volzotan/CompressorCam/README.md

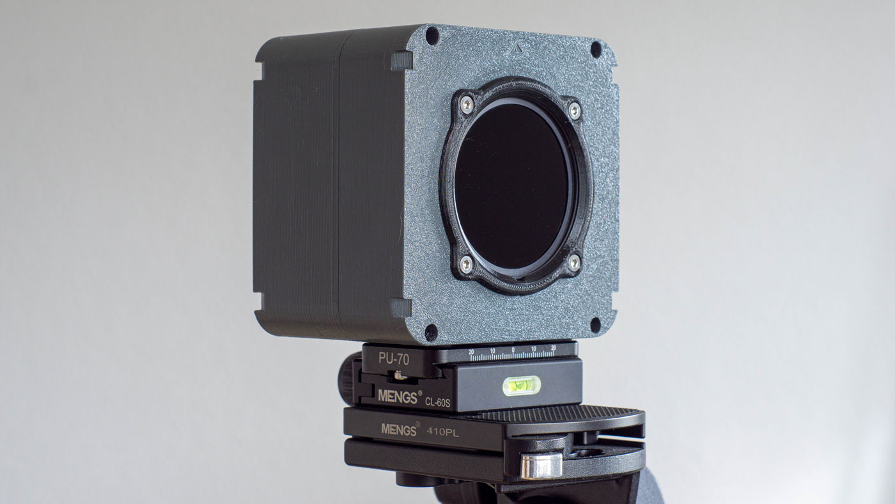
[picture p1: docs/images/front_hero.jpg]
CompressorCam


This is the complete hard- and software for the CompressorCam, a camera to capture digital solargraphy images.
For more information, refer to the [Digital Solargraphy](http://digitalsolargraphy.com) website or the README files in the subdirectories.
