volzotan/CompressorCam/hardware/README.md

# Hardware:

## Parameters for 3D-printing

Print in PETG or similarly heat-resistant material.  
The top and bottom shell of the enclosure need to be printed on a 0.4mm nozzle printer with a layer height of 0.2-0.23mm. The PogoHolder (the spacer in between PCB and Raspberry Pi Zero) needs to be printed with a 0.25mm nozzle.  
4 perimeters and an infill of 15% are reasonable.   

Avoid the color black, PETG temperatures after a few hours in the sun:
  * black: 50°C
  * dark gray: 45°C
  * white: 32°C

## BOM:

| Quantity | Type | Name | Function | 
| --- | --- | --- | --- |
| 4 | DIN912  | M3 50mm | Screw Top-Bottom | 
| 4 | DIN912  | M3 6mm  | Screw Top-Insert | 
| 4 | DIN7991 | M3 5mm  | Screw FilterHolder-Top  | 
| 8 | DIN912  | M2.5 12mm | | 
| 4 | DIN912  | M2.5 35mm | | 
| 8 | Heat-Insert | M2.5 D4.2 L5 | Insert Lens Holder  | 
| 4 | Heat-Insert | M3 D4.2 L3  | Insert Top  | 
| 8 | Heat-Insert | M3 D4.2 L7  | Insert Bottom | 
| 4 | DIN934  | M2.5 | Nut Camera Module  | 
| 1 | DIN934  | 1/4"-20 | Tripod-Nut  | 
| 162g | PETG | Filament | Top&Bottom  | 
| 25g | PETG | Filament | Everything Else | 
| 1 | | Micro SD-Card | | 
| 1 | ND64 58mm | Neutral-Density filter  | | 
| 40cm | 3mm | EPDM foam band  | | 
| 1 | 2S1P | Battery holder  | | 
| 2 | | 18650 battery | | 
| 1 | | CompressorCam board | | 
| 1 | | Pi Zero camera cable short  | | 
| 1 | | Raspberry Pi Zero W | | 
| 1 | | Raspberry Pi Camera Module HQ | |  
| 1 | | C or CS-Mount lens  | | 

# Change Log: 

## Circuit Boards:

Revision J:

  * no changes

Revision I:

  * new DCDC converter chip (TPS630701) allows 3-13V input (revH only supported 6-13V)
  * board can now be powered via MicroUSB as well 

Revision H:

  * initial release
