volzotan/CompressorCam/software/README.md

**buildroot**: All files to build a buildroot linux image including the required packages for the compressor camera software  
**bootloader**: the Arduino bootloader for the companion board  
**controllerCompressorCam**: the firmware for the companion board  
**ccam**: The python compressor camera scripts  
**compressor**: The software for stacking and peaking the captured photos to create the final solargraphy image
