volzotan/CompressorCam/software/ccam/README.md

`ccam.py` and `devices.py` are the only files required for barebones functionality.
