volzotan/CompressorCam/docs/examples.md

---
title: Example Images
imgdir: examples
permalink: examples/
---

Weimar Marktplatz
Weimar Marktplatz

Exposed for 48 hours  
3.2mm No-Name CS-Mount lens

---

Weimar Theaterplatz

Exposed for 48 hours  
4mm Arecont CS-Mount lens

---

Rudolfshuette2

Exposed for 24 hours  
3.2mm No-Name CS-Mount lens

---

Rudolfshuette3

Exposed for 12 hours  
4mm Arecont CS-Mount lens
