volzotan/CompressorCam/docs/imprint.md

---
title: Imprint
---

Legal information: This website is run by  

Christopher Getschmann  
Prager Str. 1 (C46)  
D-99427 Weimar (Germany)  

If you want to reach out to me: solargraphy@volzo.de
