volzotan/CompressorCam/docs/_assets/examples/marktplatz.jpg

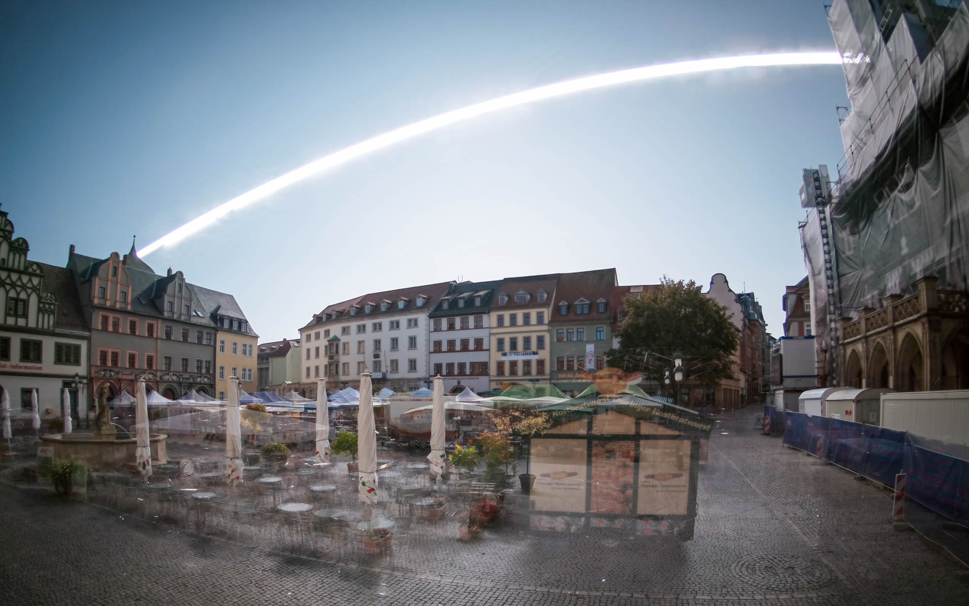
docs/_assets/examples/marktplatz.jpg
