volzotan/CompressorCam/docs/_assets/examples/regular_low_overview.jpg

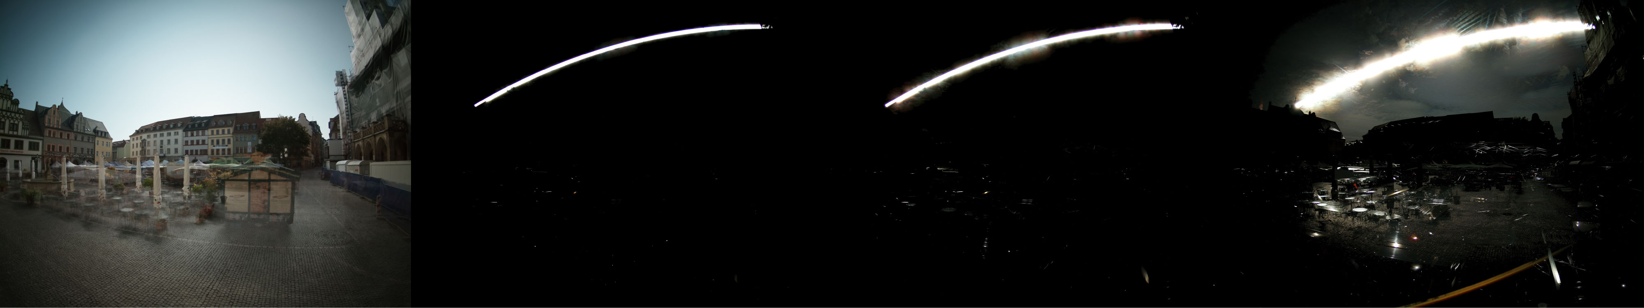
docs/_assets/examples/regular_low_overview.jpg
