volzotan/CompressorCam/docs/_assets/examples/rudolfshuette2.jpg

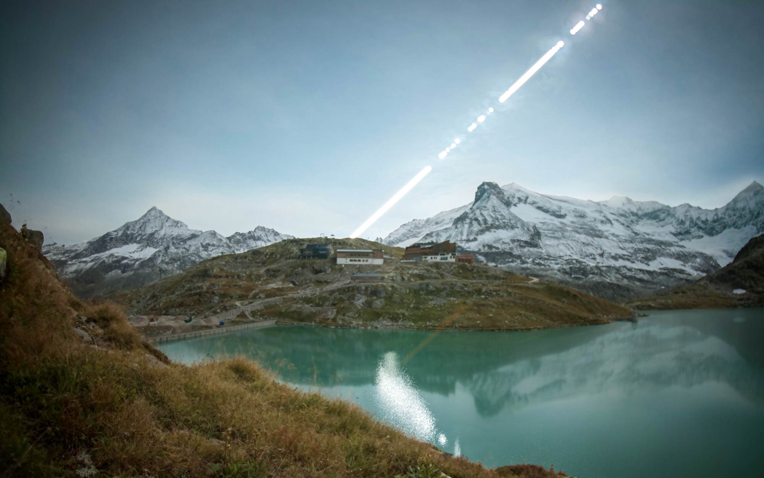
docs/_assets/examples/rudolfshuette2.jpg
