volzotan/CompressorCam/docs/_assets/examples/rudolfshuette3.jpg

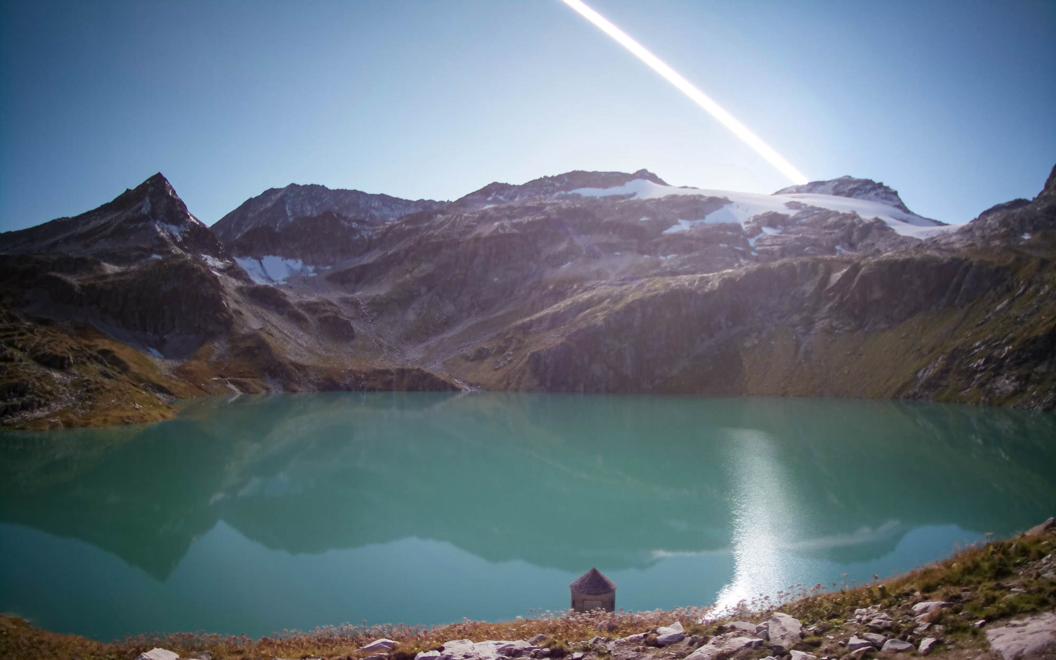
docs/_assets/examples/rudolfshuette3.jpg
