volzotan/CompressorCam/docs/_assets/examples/theaterplatz.jpg

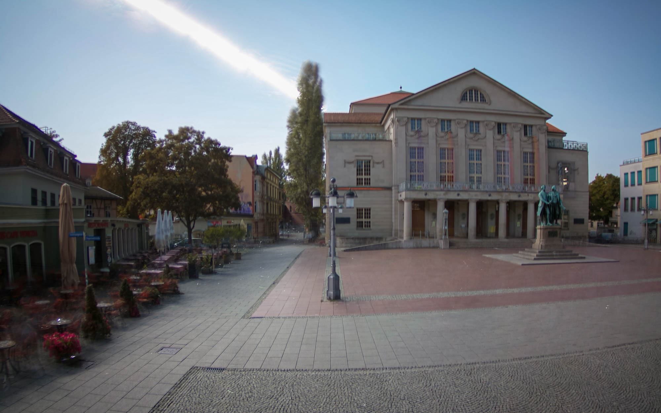
docs/_assets/examples/theaterplatz.jpg
