volzotan/CompressorCam/docs/_assets/howitworks/captures_3_cap_000750_ev_18.77.jpg

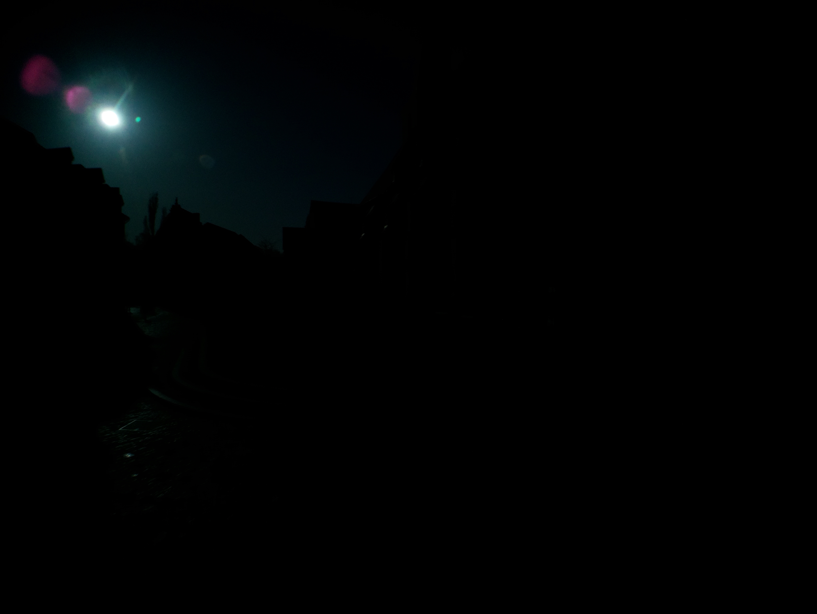
docs/_assets/howitworks/captures_3_cap_000750_ev_18.77.jpg
