volzotan/CompressorCam/docs/_assets/howitworks/herderplatz_only_averaging.jpg

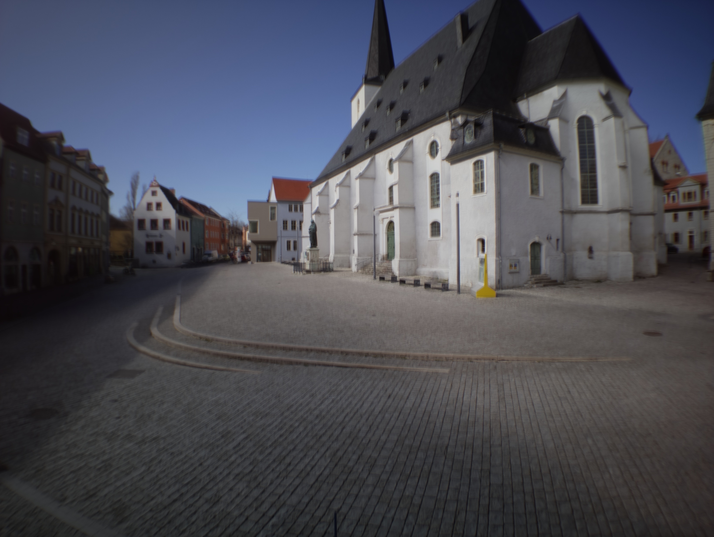
docs/_assets/howitworks/herderplatz_only_averaging.jpg
