volzotan/CompressorCam/docs/_assets/howitworks/sun_arc_artifacts.png

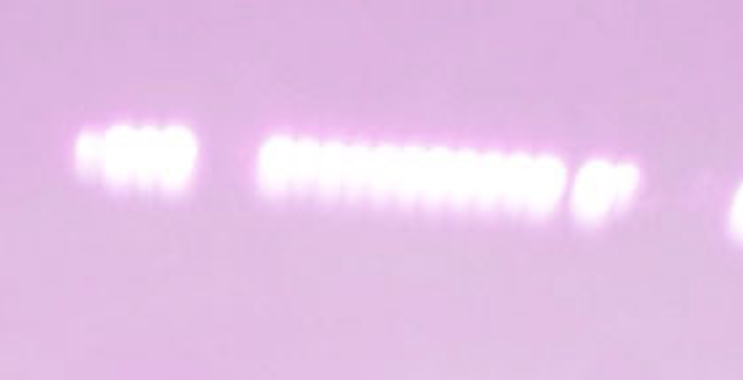
docs/_assets/howitworks/sun_arc_artifacts.png
