volzotan/CompressorCam/docs/_assets/howitworks/weimarhallenpark.jpg

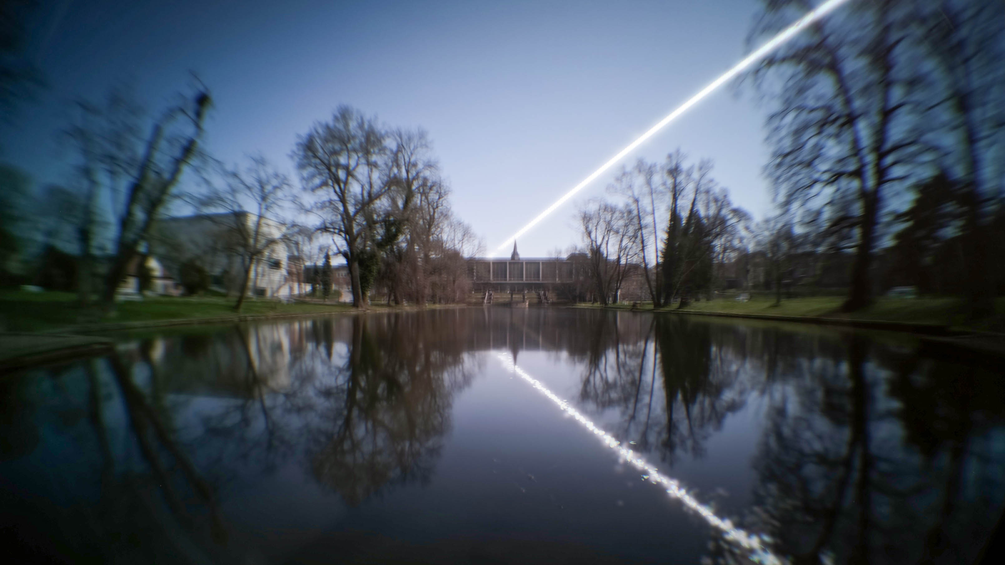
docs/_assets/howitworks/weimarhallenpark.jpg
