volzotan/CompressorCam/docs/assets/howitworks/captures_1_cap_000750_ev_11.24.jpg

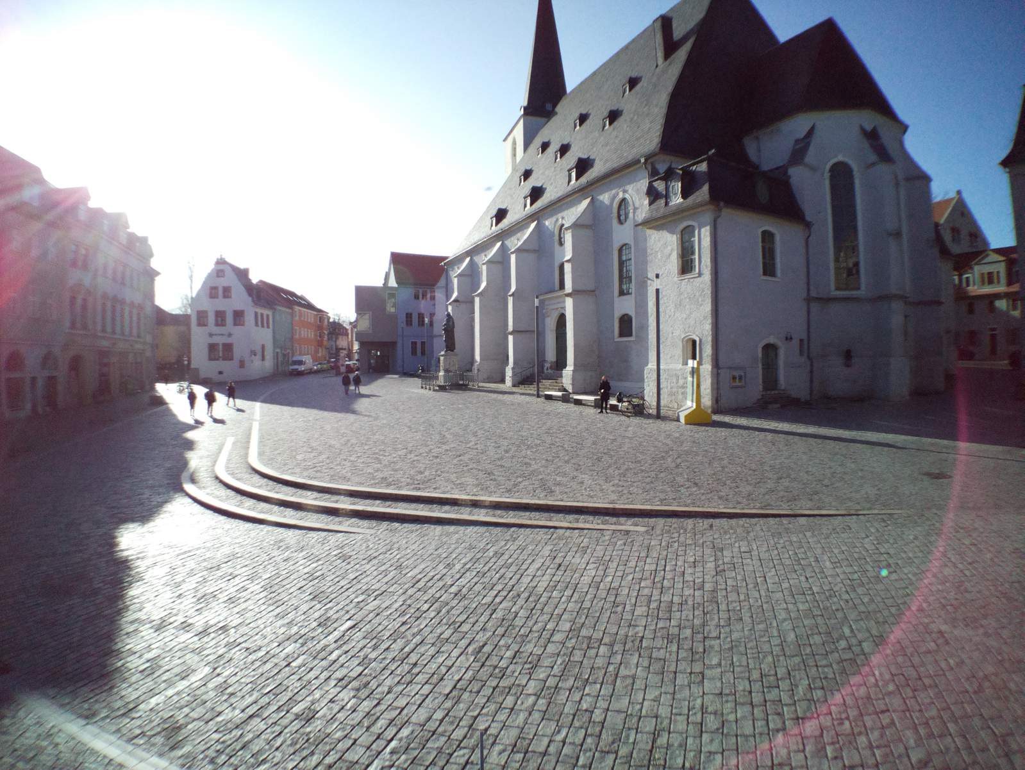
docs/assets/howitworks/captures_1_cap_000750_ev_11.24.jpg
