volzotan/CompressorCam/docs/images/front_exampleimages.jpg

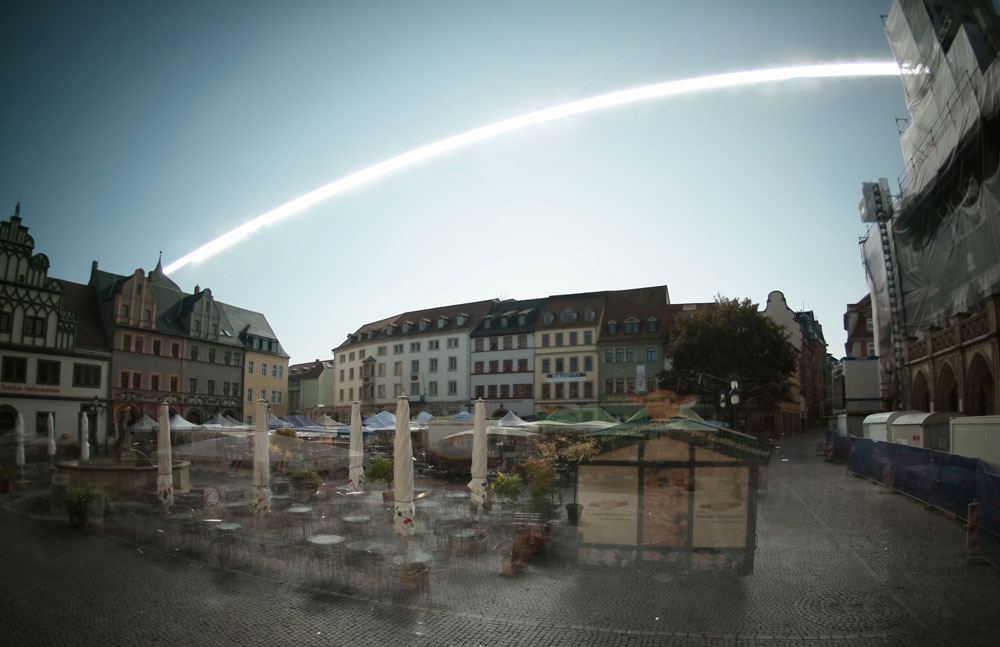
docs/images/front_exampleimages.jpg
