volzotan/CompressorCam/docs/images/front_hero2.jpg

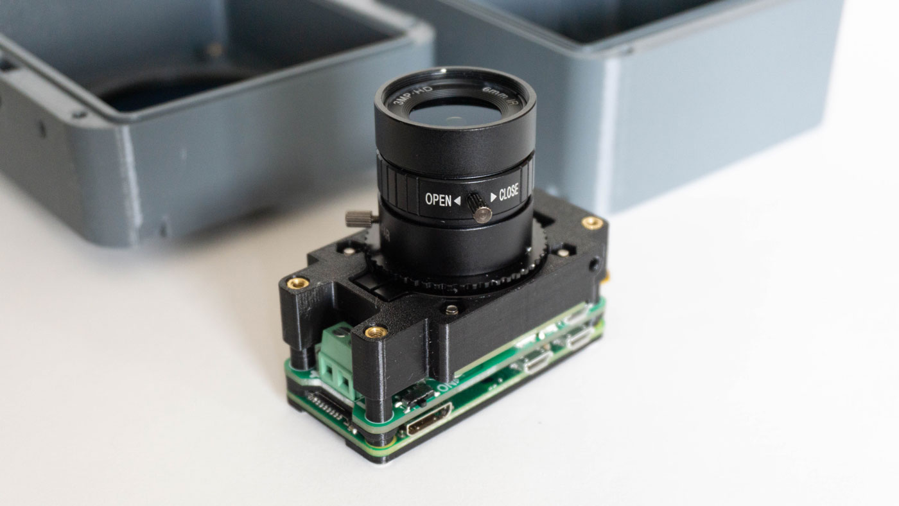
docs/images/front_hero2.jpg
