volzotan/CompressorCam/docs/images/front_hero3.jpg

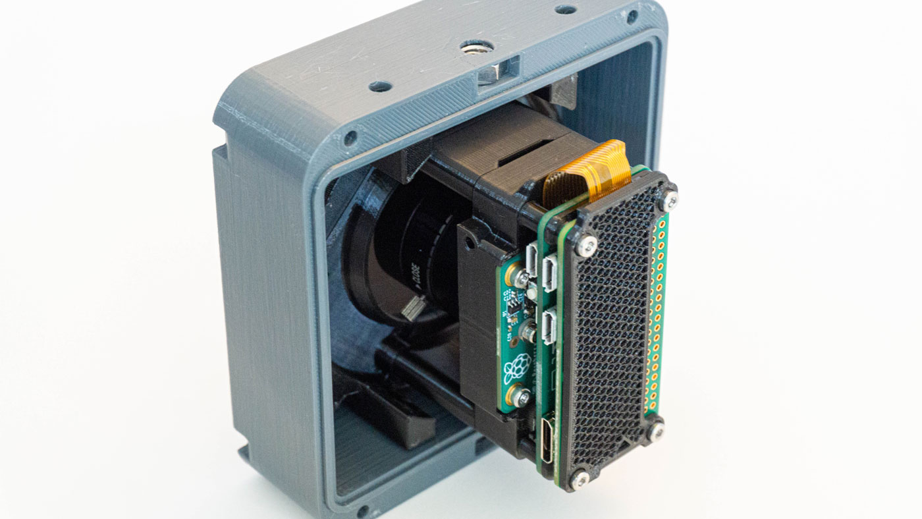
docs/images/front_hero3.jpg
