volzotan/CompressorCam/docs/images/front_screenshot.png

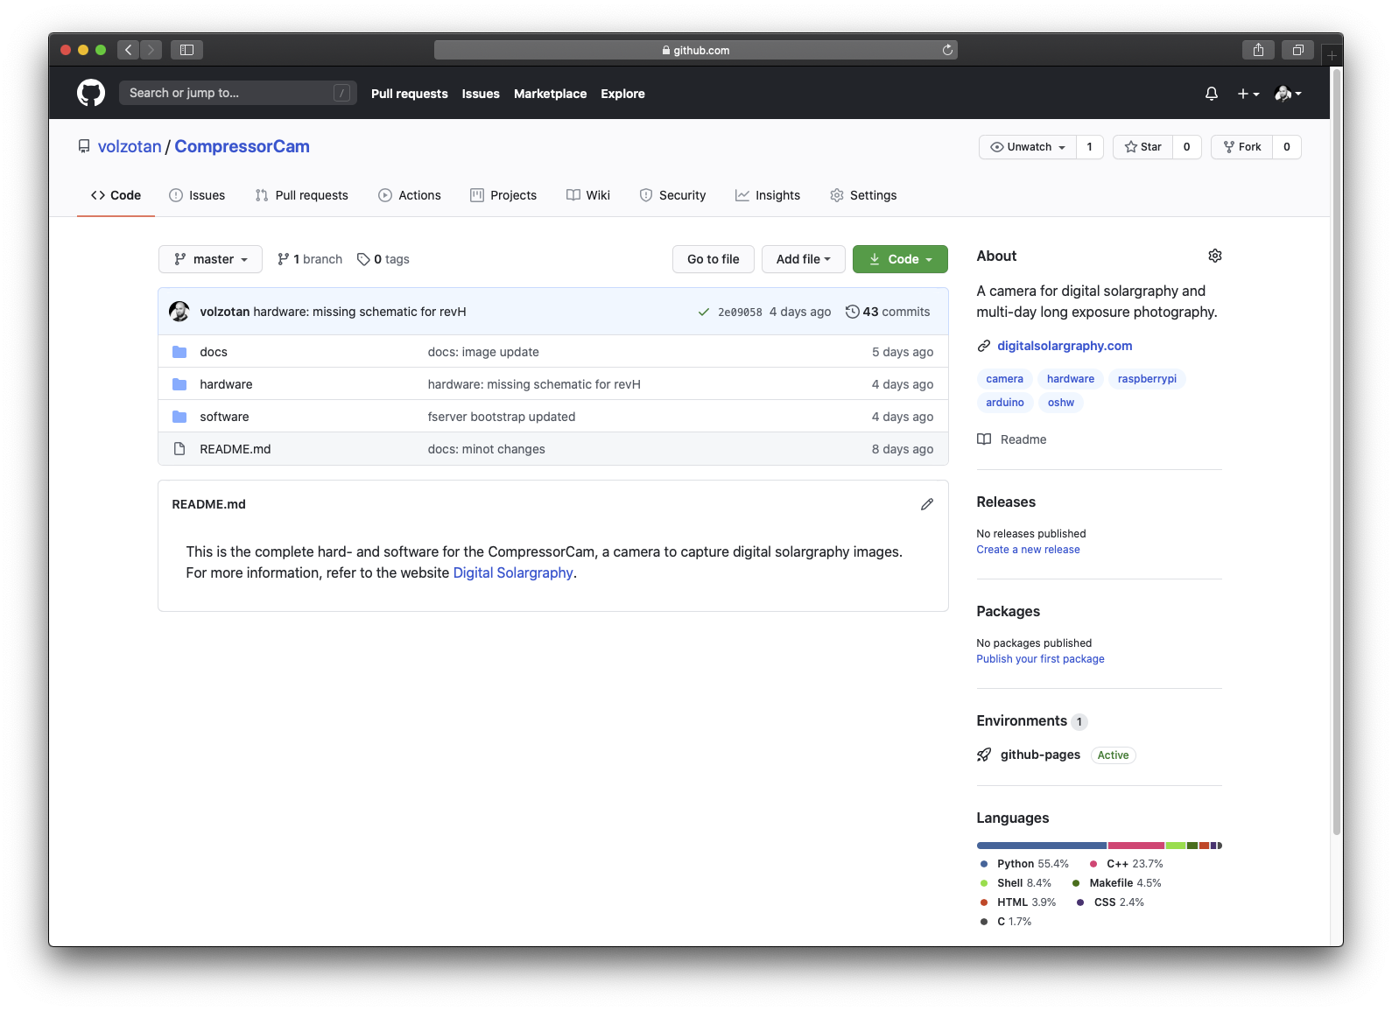
docs/images/front_screenshot.png
