volzotan/CompressorCam/hardware/gerbers/CompressorCamRevJ/BOM_CompressorCamRevJ.csv

ID | Name | Designator | Footprint | Quantity | Manufacturer Part | Manufacturer | Supplier | Supplier Part | LCSC Assembly
1 | 210S-2*5P L=11.6MMGold-plated black | H2 | HDR-TH_10P-P2.54-V-R2-C5-S2.54_MTP125-1205S1 | 1 | 210S-2*5P L=11.6MMGold-plated black | Ckmtw | LCSC | C124387
2 | SSSS811101 | SW1 | SW-TH_SSSS811101 | 1 | SSSS811101 | ALPS | LCSC | C109335
3 | 100nF | C1,C5,C13,C10 | C0805 | 4 | CC0805KRX7R9BB104 | YAGEO | LCSC | C49678 | Yes
4 | 100K | R11,R12,R14,R2 | R0805 | 4 | 0805W8F1003T5E | UniOhm | LCSC | C17407 | Yes
5 | 22uF | C7,C8,C9 | C0805 | 3 | CL21A226MAQNNNE | SAMSUNG | LCSC | C45783 | Yes
6 | 32.768KHz | X1 | OSC-SMD_L3.2-W1.5 | 1 | 9H0321LCSC-DZF2S | TXC | LCSC | C90944 | Yes
7 | MCP1703T-3302E/MB | U5 | SOT-89-3_L4.5-W2.5-P1.50-LS4.2-BR | 1 | MCP1703T-3302E/MB | MICROCHIP | LCSC | C27287 | Yes
8 | WS2812B-B | LED2 | LED-SMD_4P-L5.0-W5.0-TL_WS2812B-B | 1 | WS2812B-B | Worldsemi | LCSC | C114586 | Yes
9 | SKRTLAE010 | SW2 | KEY-SMD_SKRTLAE010 | 1 | SKRTLAE010 | ALPS | LCSC | C110293
10 | 10uF | C17,C6,C18,C19,C20 | C0805 | 5 | CL21A106KAYNNNE | SAMSUNG | LCSC | C15850 | Yes
11 | TC2030 | J2 | TAG-CONNECT_TC2030-IDC-NL | 1
12 | 33K | R13 | R0805 | 1 | 0805W8F3302T5E | UniOhm | LCSC | C17633 | Yes
13 | TPS2113APWR | U3 | TSSOP-8_L4.4-W3.0-P0.65-LS6.4-BL | 1 | TPS2113APWR | TI | LCSC | C130052 | Yes
14 | ATSAMD21G18A-AU | U1 | TQFP-48_L7.0-W7.0-P0.50-LS9.0-BL | 1 | ATSAMD21G18A-AU | MICROCHIP | LCSC | C78624 | Yes
15 | AP2553W6-7 | U6 | SOT-26_L3.0-W1.6-P0.95-LS2.8-BL | 1 | AP2553W6-7 | Diodes Incorporated | LCSC | C212302
16 | U-F-M5DD-Y-L | USB1 | MICRO-USB-SMD_MICRO-USB-18 | 1 | U-F-M5DD-Y-L | HRO | LCSC | C91146
17 | 100uF | C15 | C1210 | 1 | CL32A107MQVNNNE | SAMSUNG | LCSC | C49066 | Yes
18 | LM75AD | U8 | SOIC-8_L5.0-W4.0-P1.27-LS6.0-BL | 1 | LM75AD | NXP | LCSC | C7963 | Yes
19 | TPS630701RNMT | U4 | VQFN-15_L3.0-W2.5-P0.50-BL | 1 | TPS630701RNMT | TI | LCSC | C181473
20 | JUMPER-2SMD-NO | JP1 | SJ_2S-NO | 1
21 | 1.5uH | L1 | IND-SMD_L5.4-W5.2 | 1 | MWSA0518S-1R5MT | Sunlord | LCSC | C408344 | Yes
22 | 27pF | C3,C4 | C0805 | 2 | CL21C270JBANNNC | SAMSUNG | LCSC | C8031 | Yes
23 | Header-Female-2.54_1x3 | P1 | HDR-TH_3P-P2.54-V | 1 | Header-Female-2.54_1x3 | Boom Precision Elec | LCSC | C146243
24 | 510 | R17 | R0805 | 1 | 0805W8F5100T5E | UniOhm | LCSC | C17734 | Yes
25 | 10K | R1,R6,R7,R8,R9,R10,R15,R3 | R0805 | 8 | 0805W8F1002T5E | UniOhm | LCSC | C17414 | Yes
26 | JL127-50802G01 | U7 | CONN-TH_2P-P5.08_JL127-50802G01 | 1 | JL127-50802G01 | JILN | LCSC | C409161
27 | 1uF | C2,C14,C16,C11,C12 | C0805 | 5 | CL21B105KBFNNNE | SAMSUNG | LCSC | C28323 | Yes
