volzotan/CompressorCam/hardware/gerbers/CompressorCamRevH/BOM_CompressorCamRevH.csv

ID | Name | Designator | Footprint | Quantity | Manufacturer Part | Manufacturer | Supplier | Supplier Part | LCSC Assembly
1 | 10uH | L1 | IND-SMD_L7.1-W6.6 | 1 | MWSA0618-100MT | Sunlord | LCSC | C132135 | Yes
2 | 210S-2*5P L=11.6MMGold-plated black | H2 | HDR-TH_10P-P2.54-V-R2-C5-S2.54_MTP125-1205S1 | 1 | 210S-2*5P L=11.6MMGold-plated black | Ckmtw | LCSC | C124387
3 | SSSS811101 | SW1 | SW-TH_SSSS811101 | 1 | SSSS811101 | ALPS | LCSC | C109335
4 | 100nF | C6,C13,C1,C5 | C0805 | 4 | CC0805KRX7R9BB104 | YAGEO | LCSC | C49678 | Yes
5 | 100K | R2,R11 | R0805 | 2 | 0805W8F1003T5E | UniOhm | LCSC | C17407 | Yes
6 | 22uF | C10 | C1206 | 1 | CL31A226KPHNNNE | SAMSUNG | LCSC | C5672 | Yes
7 | MCP9808-E/MS | U3 | MSOP-8_L3.0-W3.0-P0.65-LS4.9-TL | 1 | MCP9808-E/MS | Microchip Tech | LCSC | C94847 | Yes
8 | 32.768KHz | X1 | OSC-SMD_L3.2-W1.5 | 1 | 9H0321LCSC-DZF2S | TXC | LCSC | C90944 | Yes
9 | B340A | D1 | SMA_L4.3-W2.6-LS5.2-RD | 1 | B340A | MDD | LCSC | C64982 | Yes
10 | MCP1703T-3302E/MB | U5 | SOT-89-3_L4.5-W2.5-P1.50-LS4.2-BR | 1 | MCP1703T-3302E/MB | MICROCHIP | LCSC | C27287 | Yes
11 | WS2812B-B | LED2 | LED-SMD_4P-L5.0-W5.0-TL_WS2812B-B | 1 | WS2812B-B | Worldsemi | LCSC | C114586 | Yes
12 | SKRTLAE010 | SW2 | KEY-SMD_SKRTLAE010 | 1 | SKRTLAE010 | ALPS | LCSC | C110293
13 | 10uF | C17 | C0805 | 1 | CL21A106KAYNNNE | SAMSUNG | LCSC | C15850 | Yes
14 | MP2307DN-LF-Z | U2 | SOP-8_L4.9-W3.9-P1.27-LS6.0-BL-EP | 1 | MP2307DN-LF-Z | MPS | LCSC | C18921 | Yes
15 | 6.8K | R3 | R0805 | 1 | 0805W8F6801T5E | UniOhm | LCSC | C17772 | Yes
16 | TC2030 | J2 | TAG-CONNECT_TC2030-IDC-NL | 1
17 | 33K | R13 | R0805 | 1 | 0805W8F3302T5E | UniOhm | LCSC | C17633 | Yes
18 | ATSAMD21G18A-AU | U1 | TQFP-48_L7.0-W7.0-P0.50-LS9.0-BL | 1 | ATSAMD21G18A-AU | MICROCHIP | LCSC | C78624 | Yes
19 | AP2553W6-7 | U6 | SOT-26_L3.0-W1.6-P0.95-LS2.8-BL | 1 | AP2553W6-7 | Diodes Incorporated | LCSC | C212302
20 | U-F-M5DD-Y-L | USB1 | MICRO-USB-SMD_MICRO-USB-18 | 1 | U-F-M5DD-Y-L | HRO | LCSC | C91146
21 | 3.9uF | C19 | C0805 | 1 | CL21B335KPFNNNE | Samsung Electro-Mechanics | LCSC | C159775 | Yes
22 | 100uF | C15 | C1210 | 1 | CL32A107MQVNNNE | SAMSUNG | LCSC | C49066 | Yes
23 | 10uF | C7 | C1206 | 1 | CL31A106KBHNNNE | SAMSUNG | LCSC | C13585 | Yes
24 | JUMPER-2SMD-NO | JP1 | SJ_2S-NO | 1
25 | 27pF | C3,C4 | C0805 | 2 | CL21C270JBANNNC | SAMSUNG | LCSC | C8031 | Yes
26 | Header-Female-2.54_1x3 | P1 | HDR-TH_3P-P2.54-V | 1 | Header-Female-2.54_1x3 | Boom Precision Elec | LCSC | C146243
27 | 10K | R4,R1,R6,R7,R8,R9,R10 | R0805 | 7 | 0805W8F1002T5E | UniOhm | LCSC | C17414 | Yes
28 | JL127-50802G01 | U7 | CONN-TH_2P-P5.08_JL127-50802G01 | 1 | JL127-50802G01 | JILN | LCSC | C409161
29 | 44.2K | R5 | R0805 | 1 | 0805W8F4422T5E | UniOhm | LCSC | C17697 | Yes
30 | 1uF | C11,C12,C2,C14,C16 | C0805 | 5 | CL21B105KBFNNNE | SAMSUNG | LCSC | C28323 | Yes
31 | 10nF | C9 | C0805 | 1 | CL21B103KBANNNC | SAMSUNG | LCSC | C1710 | Yes
