volzotan/CompressorCam/hardware/STEPs/LensHolderLQ.step

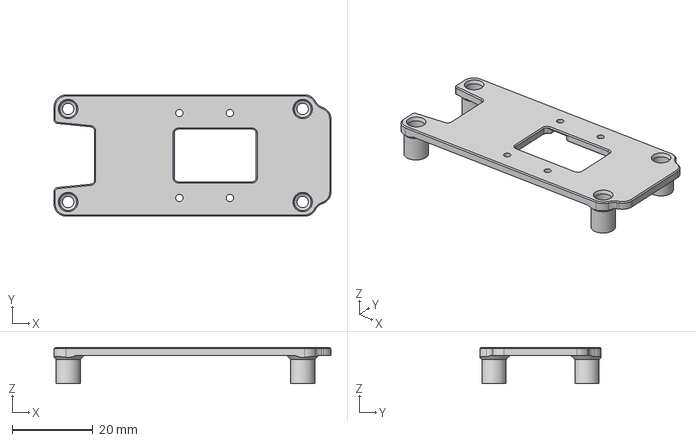
[picture p16: CAD file, 2025-11-16]
hardware/STEPs/LensHolderLQ.step
68.5 x 30.0 x 9.00 mm
