volzotan/CompressorCam/hardware/STLs/CCE_M_MagnetHolder.stl

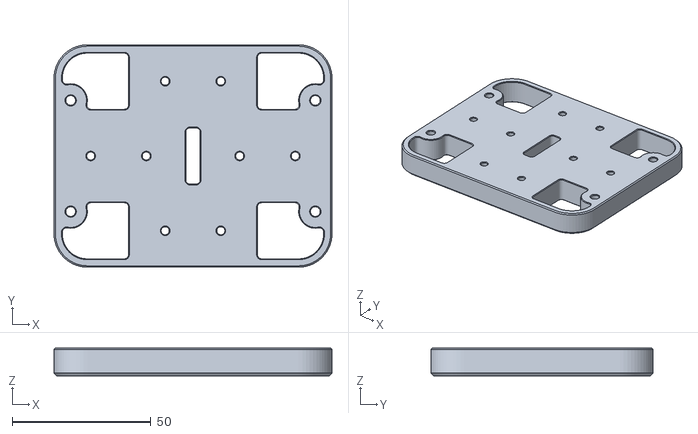
[picture p17: CAD file, 2025-11-16]
hardware/STLs/CCE_M_MagnetHolder.stl
100.0 x 80.0 x 10.0
