volzotan/CompressorCam/hardware/STEPs/LensHolderHQ.step

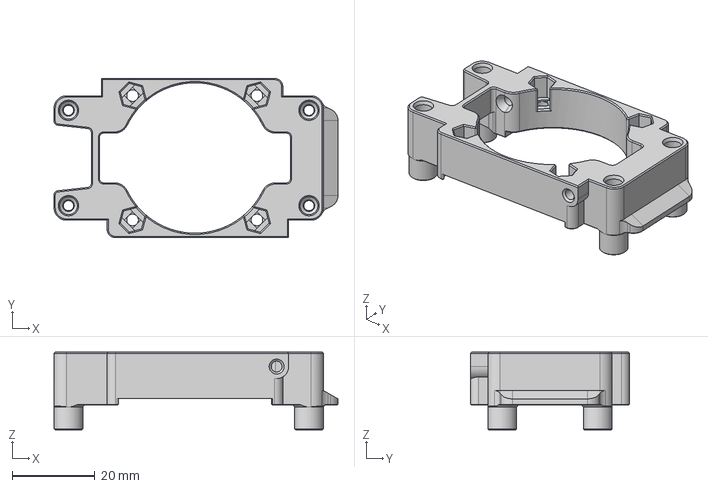
[picture p18: CAD file, 2025-11-16]
hardware/STEPs/LensHolderHQ.step
68.5 x 38.4 x 18.8 mm
