volzotan/CompressorCam/hardware/STLs/LensHolderHQ_BottomWago.stl

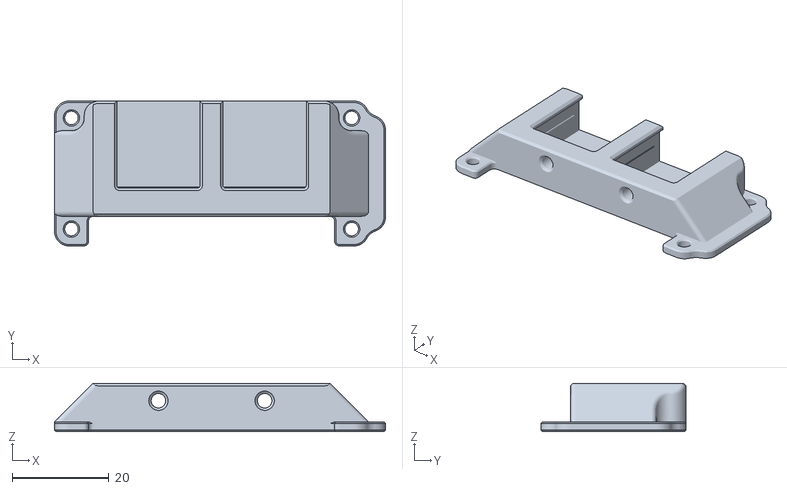
[picture p19: CAD file, 2025-11-16]
hardware/STLs/LensHolderHQ_BottomWago.stl
68.5 x 30.0 x 10.0
