volzotan/CompressorCam/hardware/STEPs/DigitalSolargraphyCamera v28.step

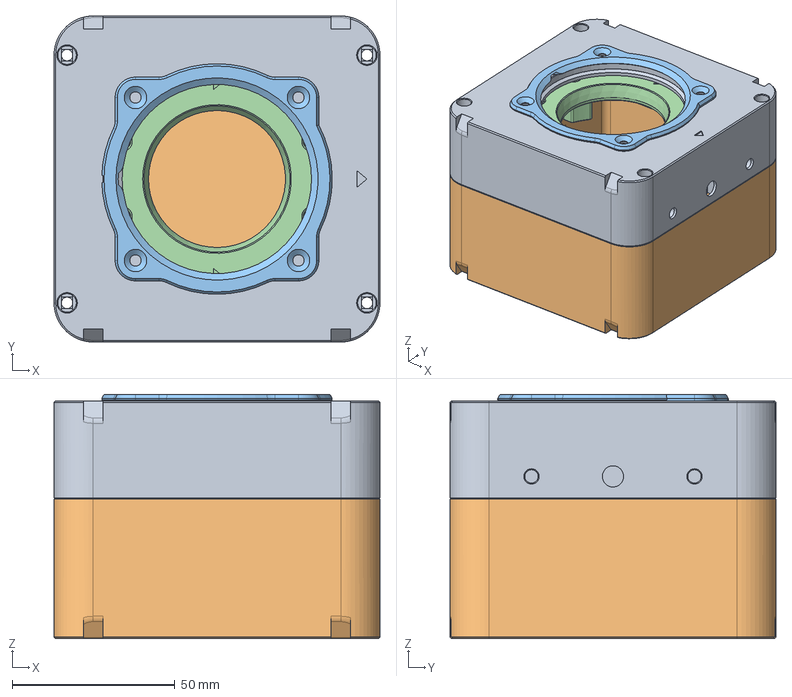
[picture p20: CAD file, 2020-09-20]
hardware/STEPs/DigitalSolargraphyCamera v28.step
100.0 x 100.0 x 75.0 mm
Top
Bottom
FilterHolder
Insert
