volzotan/CompressorCam/hardware/STLs/BatteryWagoHolder1.stl

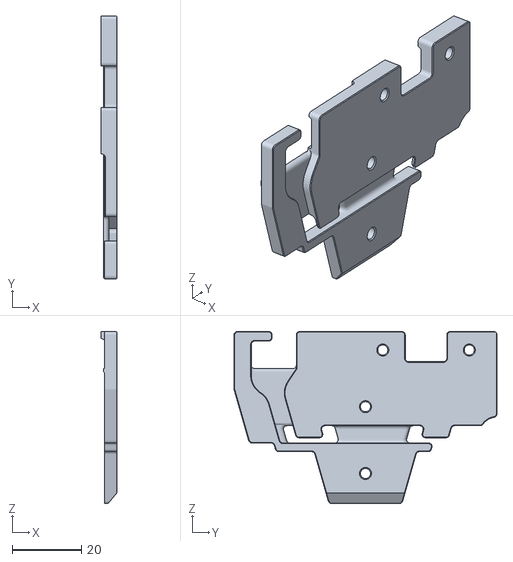
[picture p21: CAD file, 2025-11-16]
hardware/STLs/BatteryWagoHolder1.stl
4.50 x 76.0 x 49.8
