volzotan/CompressorCam/hardware/STLs/BatteryWagoHolder2.stl

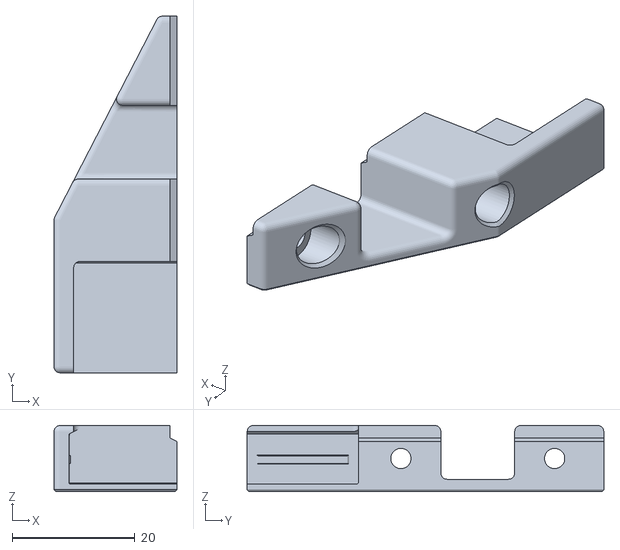
[picture p22: CAD file, 2025-11-16]
hardware/STLs/BatteryWagoHolder2.stl
20.0 x 58.0 x 10.8
