volzotan/CompressorCam/hardware/STLs/CCE_XL_Top.stl

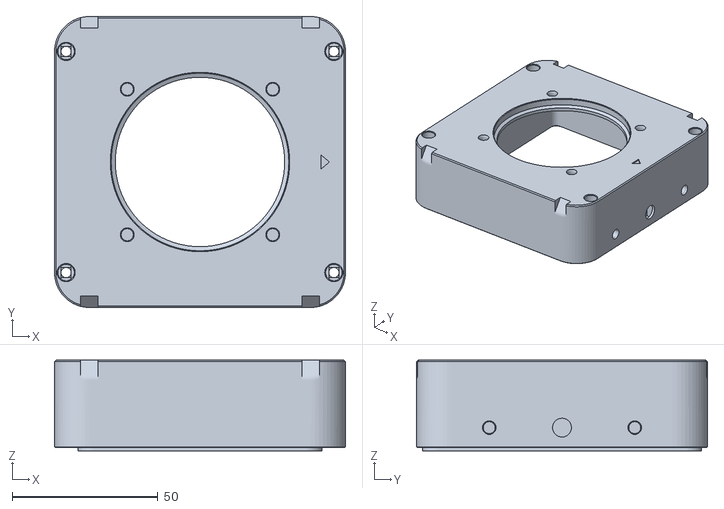
[picture p23: CAD file, 2021-07-09]
hardware/STLs/CCE_XL_Top.stl
100.0 x 100.0 x 31.2
