volzotan/CompressorCam/hardware/STLs/CCE_XL_FilterHolder.stl

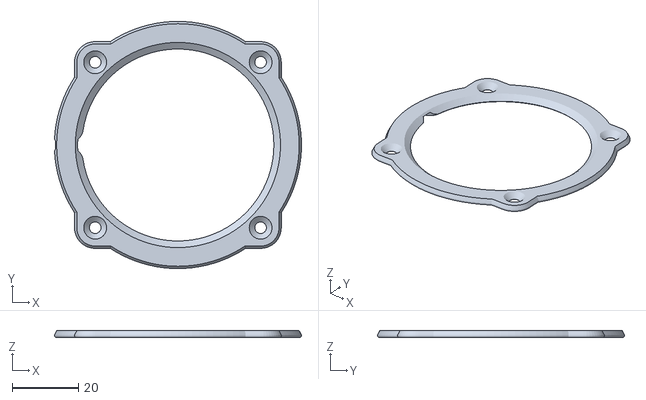
[picture p24: CAD file, 2021-07-09]
hardware/STLs/CCE_XL_FilterHolder.stl
74.7 x 74.7 x 2.00
