volzotan/CompressorCam/hardware/STLs/LensHolderHQ_PogoHolder.stl

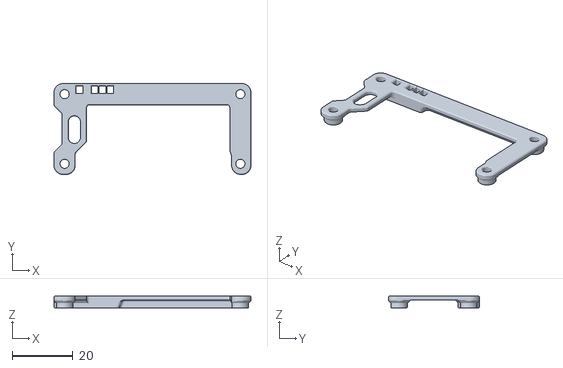
[picture p25: CAD file, 2021-07-09]
hardware/STLs/LensHolderHQ_PogoHolder.stl
65.0 x 30.0 x 4.00
