volzotan/CompressorCam/hardware/STLs/CCE_XL_Insert.stl

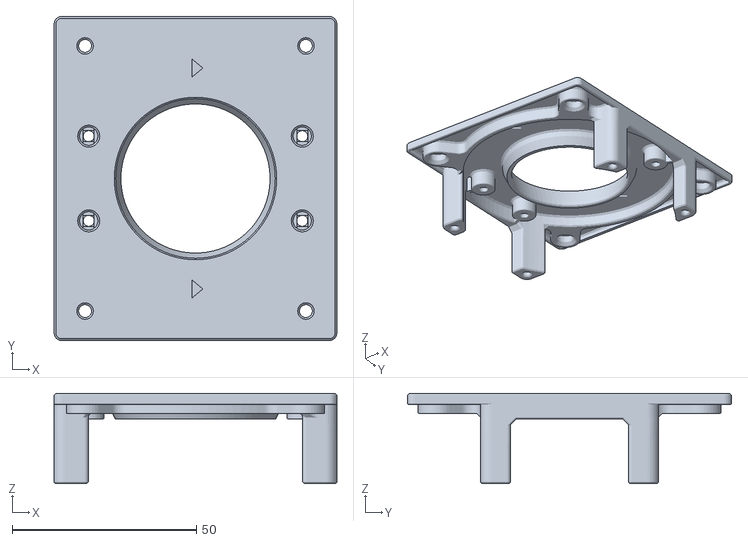
[picture p26: CAD file, 2021-07-09]
hardware/STLs/CCE_XL_Insert.stl
76.8 x 88.0 x 24.5
