volzotan/CompressorCam/hardware/STLs/CCE_XL_ColdshoeAdapter.stl

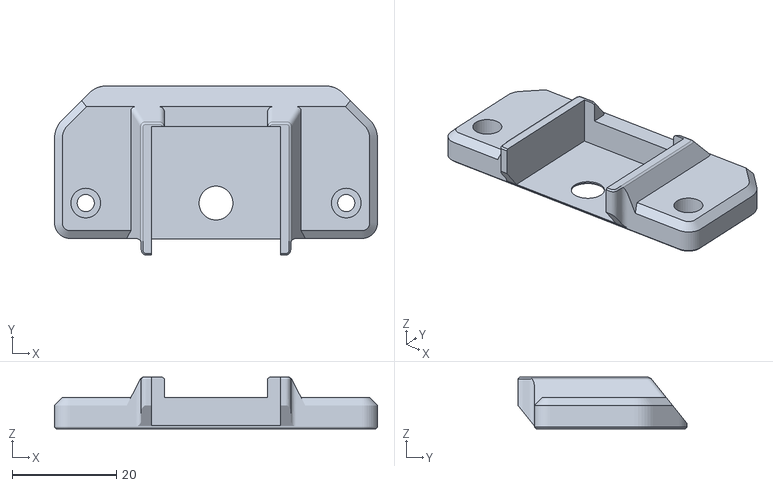
[picture p27: CAD file, 2021-07-09]
hardware/STLs/CCE_XL_ColdshoeAdapter.stl
62.0 x 32.5 x 9.90
