volzotan/CompressorCam/hardware/STLs/CCE_XL_Bottom.stl

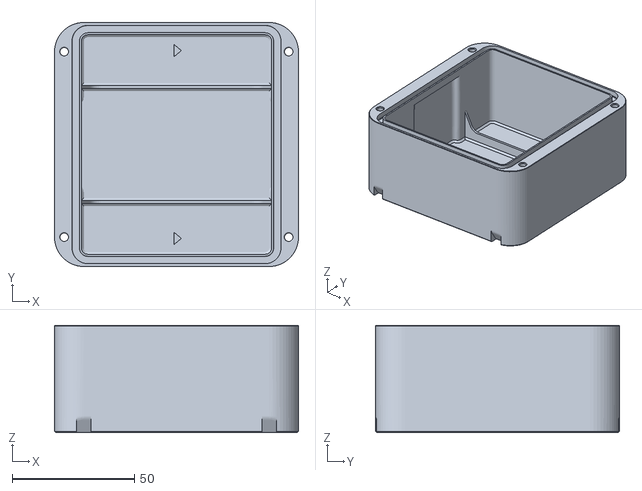
[picture p28: CAD file, 2021-07-09]
hardware/STLs/CCE_XL_Bottom.stl
100.0 x 100.0 x 44.0
