volzotan/CompressorCam/hardware/STLs/LensHolderHQ_Bottom.stl

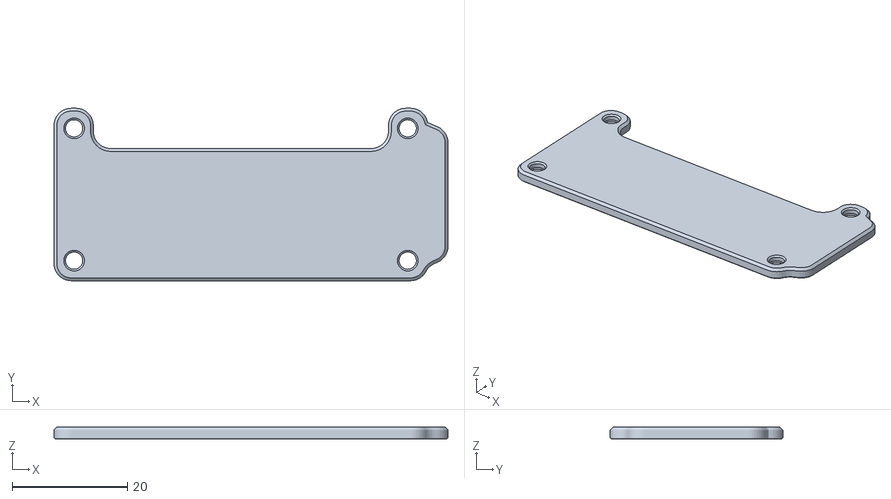
[picture p29: CAD file, 2020-10-02]
hardware/STLs/LensHolderHQ_Bottom.stl
68.5 x 30.0 x 2.10
