volzotan/CompressorCam/hardware/STLs/LensHolderHQ_Bottom_Cutout.stl

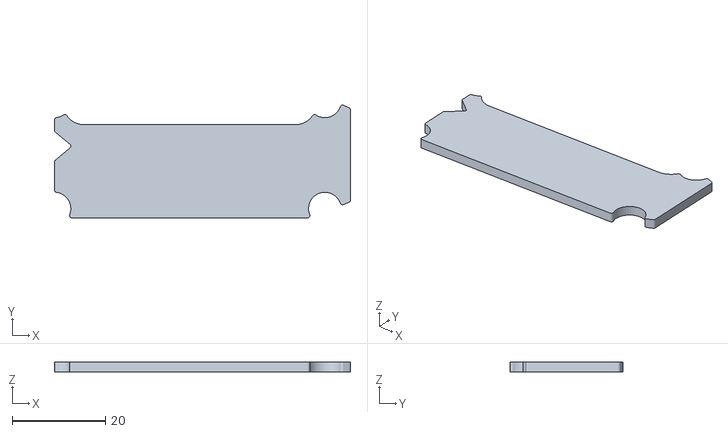
[picture p30: CAD file, 2020-10-02]
hardware/STLs/LensHolderHQ_Bottom_Cutout.stl
63.5 x 24.2 x 2.10
