volzotan/CompressorCam/hardware/STLs/LensHolderHQ_MountScrewSpacer.stl

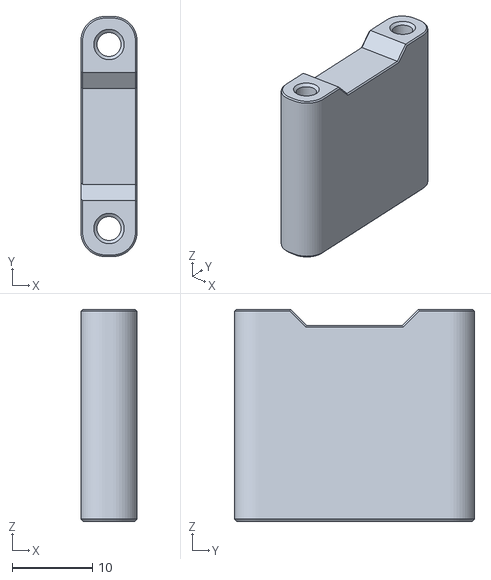
[picture p31: CAD file, 2020-09-16]
hardware/STLs/LensHolderHQ_MountScrewSpacer.stl
7.00 x 30.0 x 26.5
