volzotan/CompressorCam/(list of files, cad)

Other CAD files:
hardware/STLs/LensHolderHQ_HolderSimple.stl
hardware/STLs/LensHolderLQ_Top.stl
hardware/STEPs/LensHolderHQ.f3d
hardware/STEPs/LensHolderLQ.f3d
