volzotan/CompressorCam/docs/guides/index.md

---
title: Guides
---

[Assembly]({% link assembly.md %})

[Troubleshooting Guide]({% link troubleshooting.md %})

[Software Updates]({% link guides/software_update.md %})
