volzotan/CompressorCam/docs/_assets/assembly/1.jpg

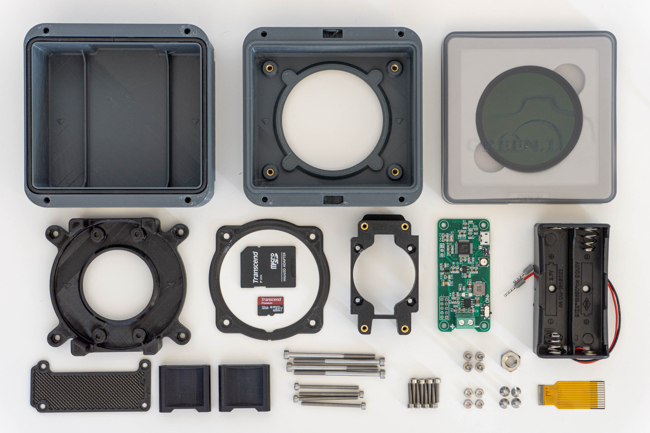
docs/_assets/assembly/1.jpg
