volzotan/CompressorCam/docs/_assets/assembly/2.jpg

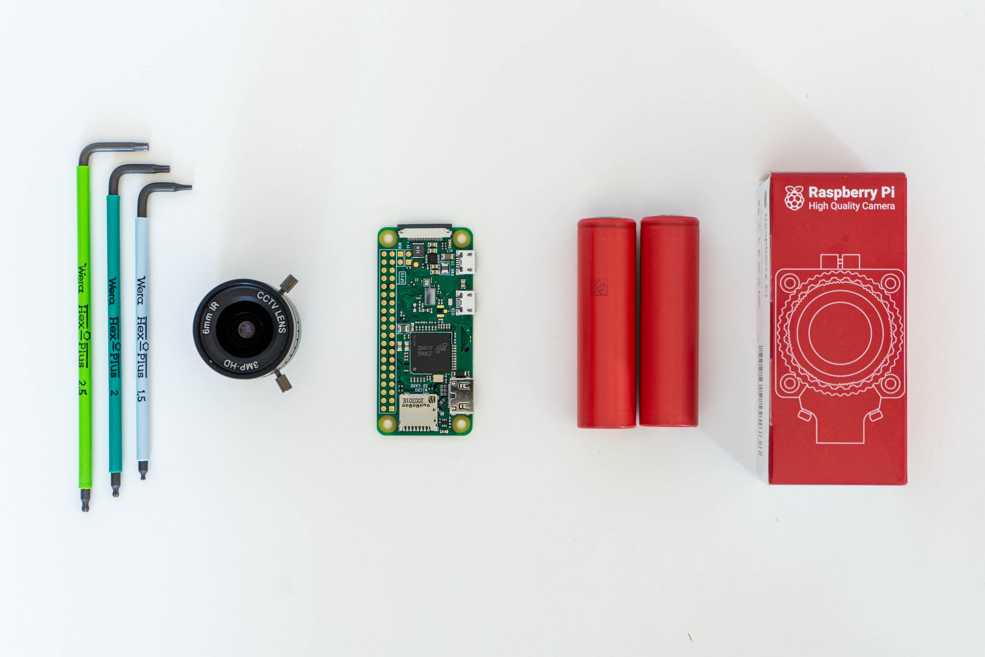
docs/_assets/assembly/2.jpg
