volzotan/CompressorCam/docs/_assets/assembly/100.jpg

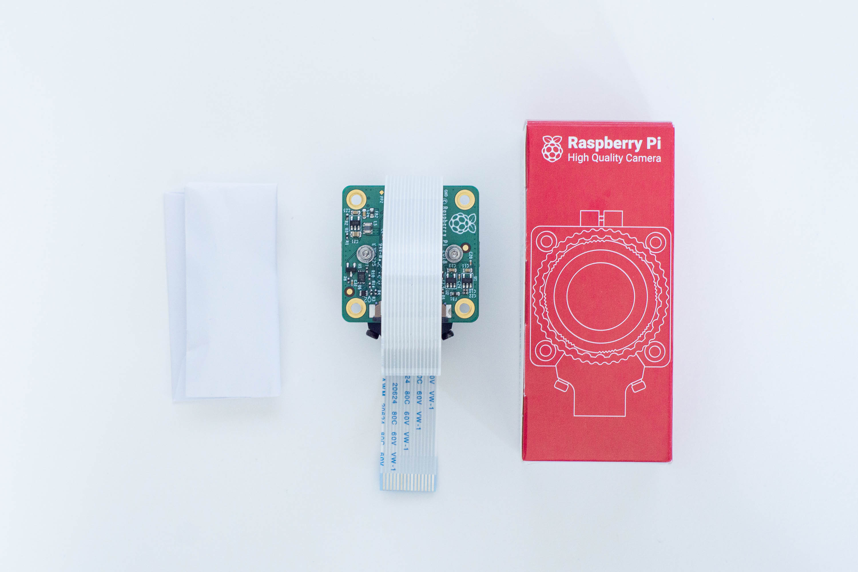
docs/_assets/assembly/100.jpg
