volzotan/CompressorCam/docs/_assets/assembly/101.jpg

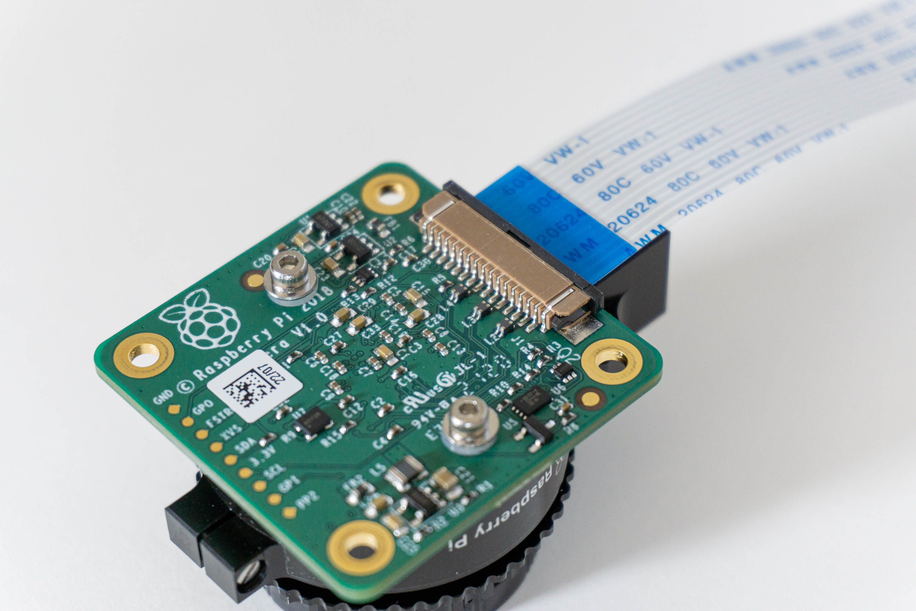
docs/_assets/assembly/101.jpg
