volzotan/CompressorCam/docs/_assets/assembly/102.jpg

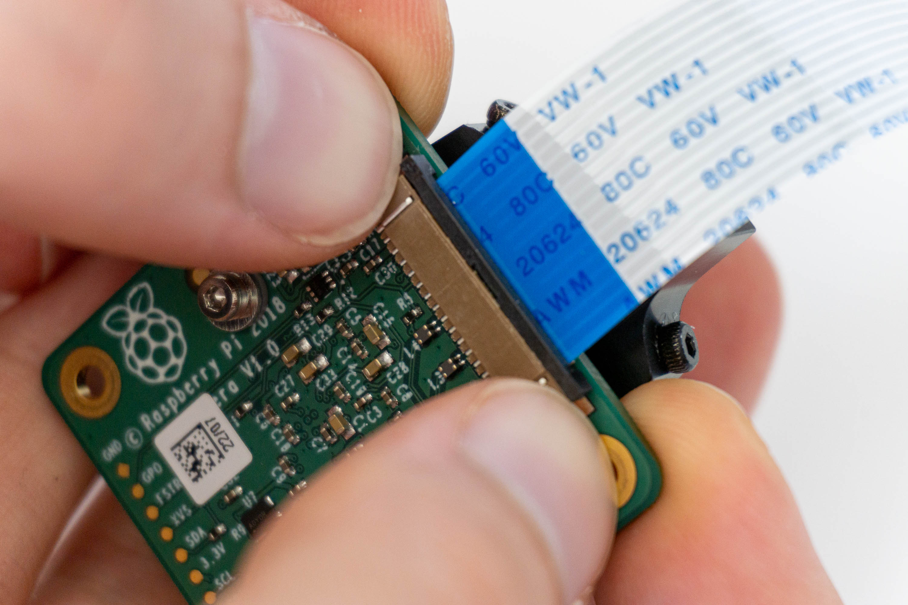
docs/_assets/assembly/102.jpg
