volzotan/CompressorCam/docs/_assets/assembly/103.jpg

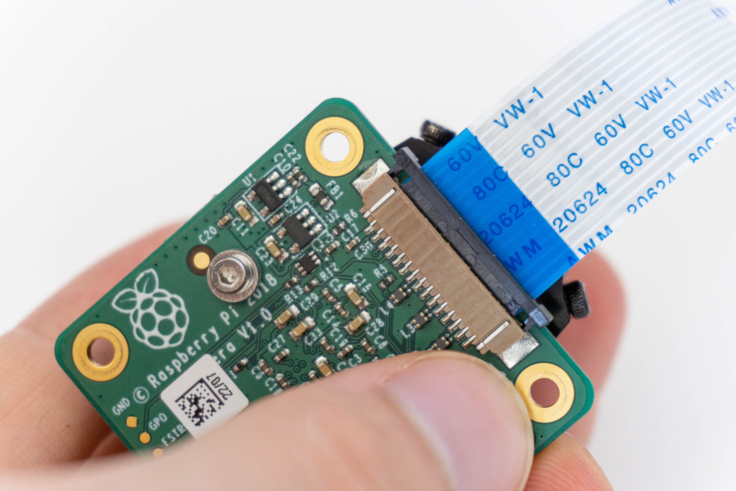
docs/_assets/assembly/103.jpg
