volzotan/CompressorCam/docs/_assets/assembly/104.jpg

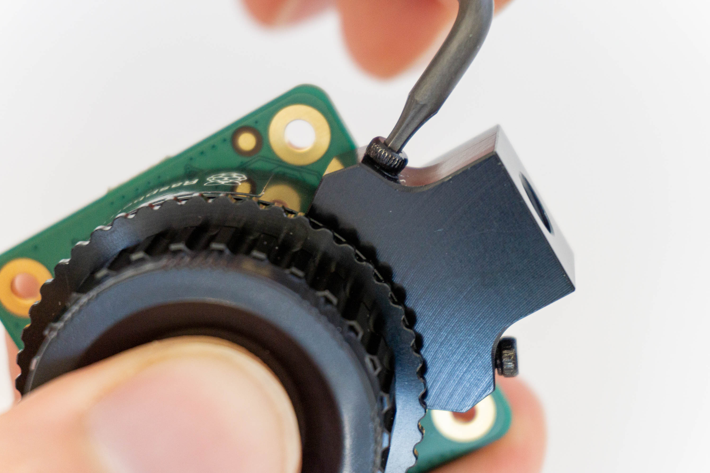
docs/_assets/assembly/104.jpg
