volzotan/CompressorCam/docs/_assets/assembly/105.jpg

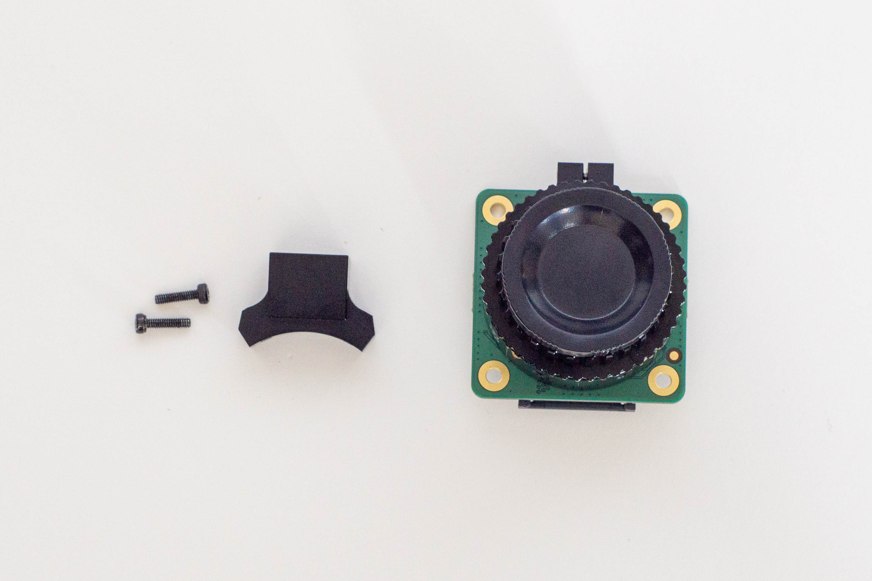
docs/_assets/assembly/105.jpg
