volzotan/CompressorCam/docs/_assets/assembly/110.jpg

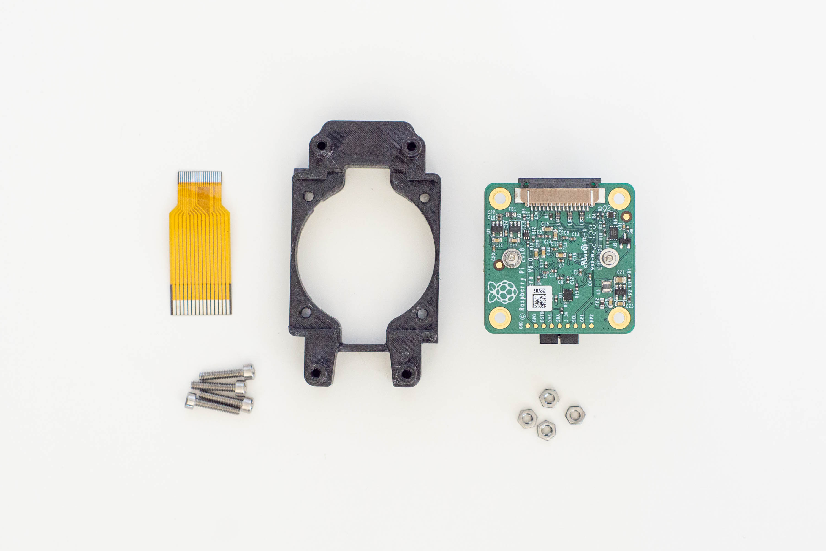
docs/_assets/assembly/110.jpg
