volzotan/CompressorCam/docs/_assets/assembly/111.jpg

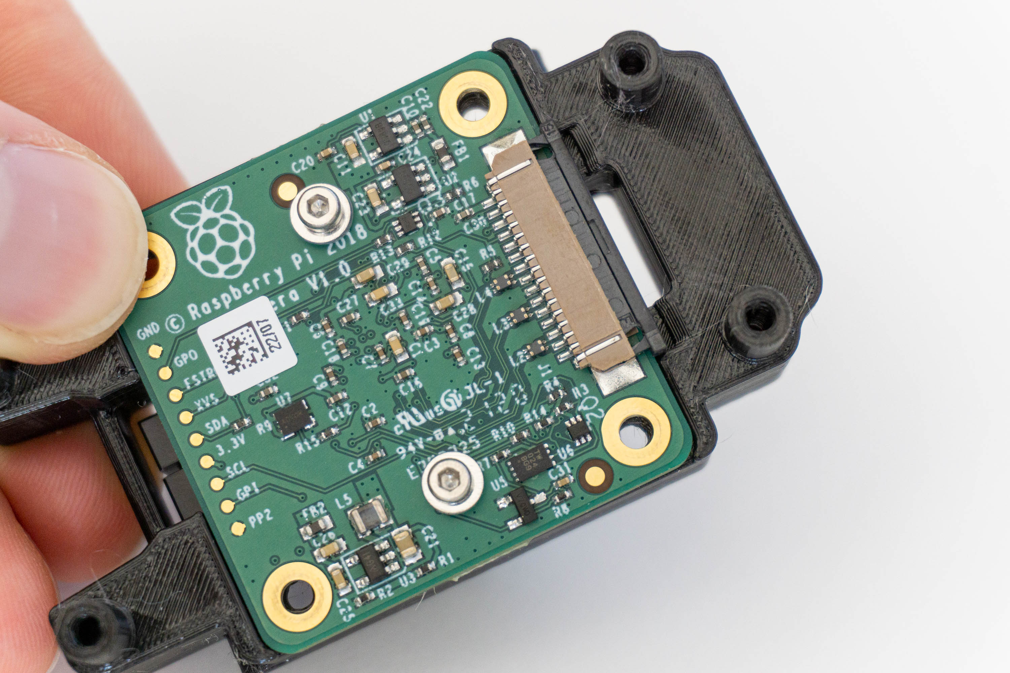
docs/_assets/assembly/111.jpg
