volzotan/CompressorCam/docs/_assets/assembly/112.jpg

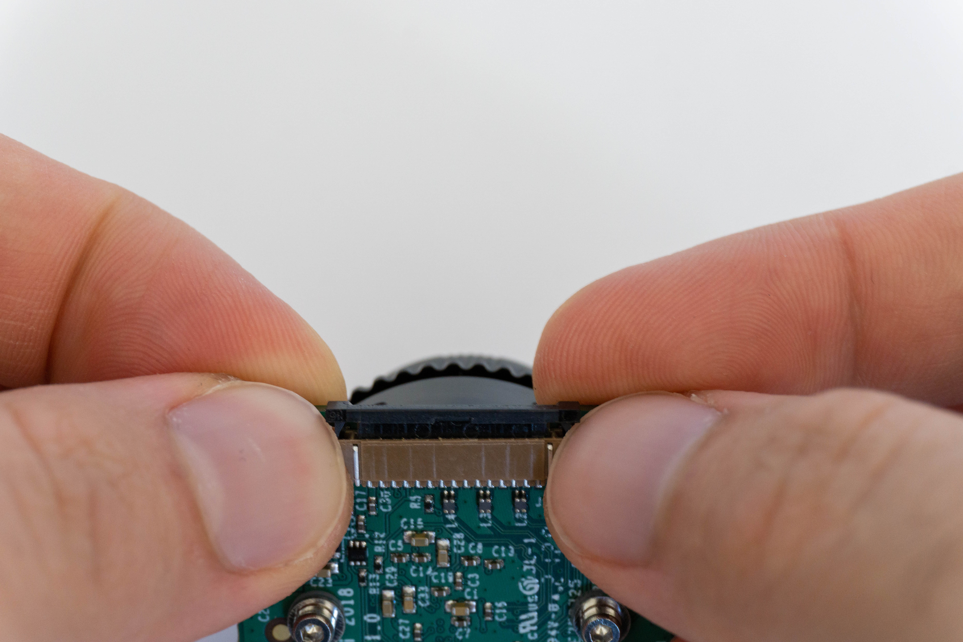
docs/_assets/assembly/112.jpg
