volzotan/CompressorCam/docs/_assets/assembly/113.jpg

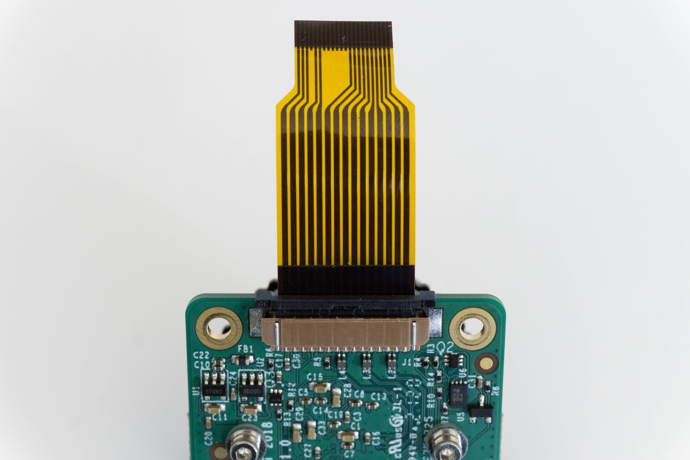
docs/_assets/assembly/113.jpg
