volzotan/CompressorCam/docs/_assets/assembly/114.jpg

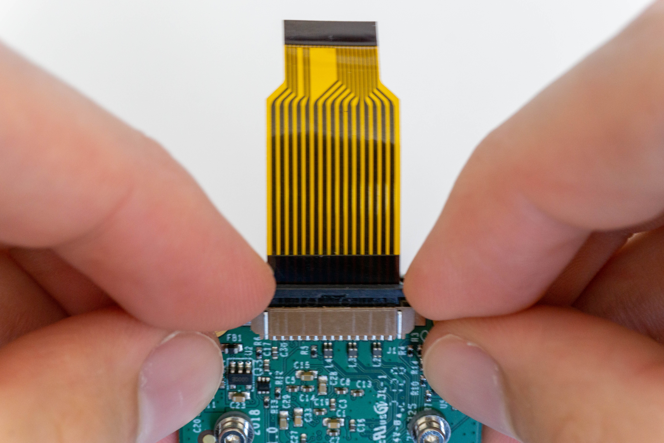
docs/_assets/assembly/114.jpg
