volzotan/CompressorCam/docs/_assets/assembly/116.jpg

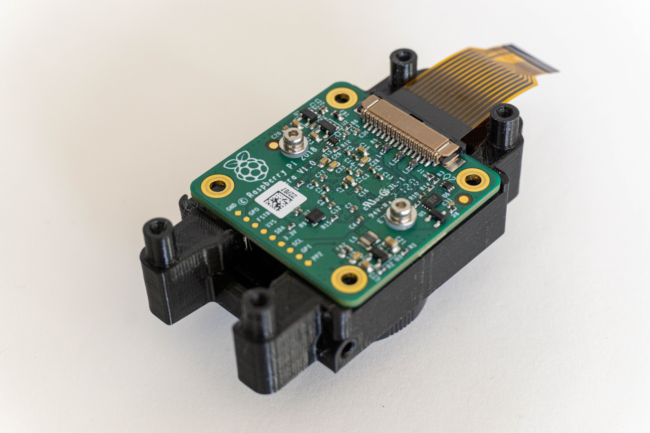
docs/_assets/assembly/116.jpg
