volzotan/CompressorCam/docs/_assets/assembly/117.jpg

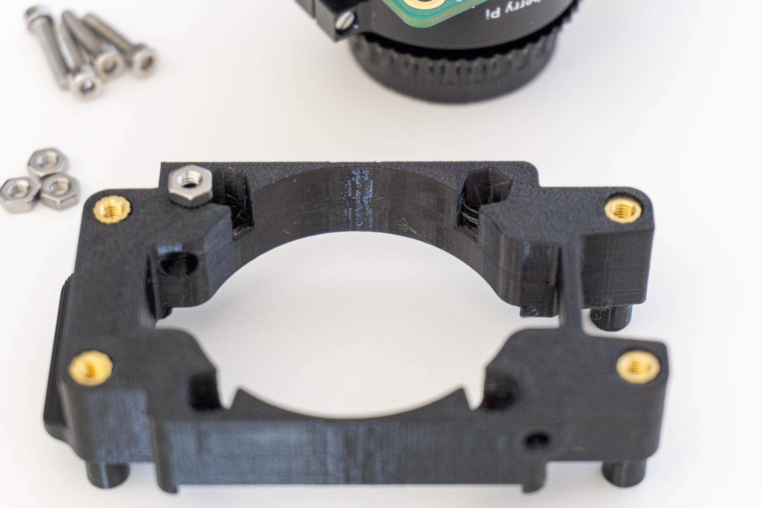
docs/_assets/assembly/117.jpg
