volzotan/CompressorCam/docs/_assets/assembly/118.jpg

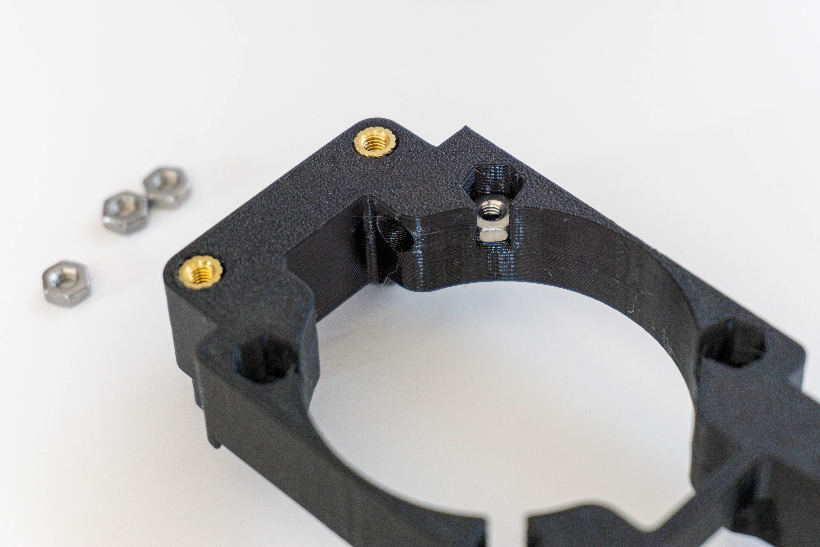
docs/_assets/assembly/118.jpg
