volzotan/CompressorCam/docs/_assets/assembly/119.jpg

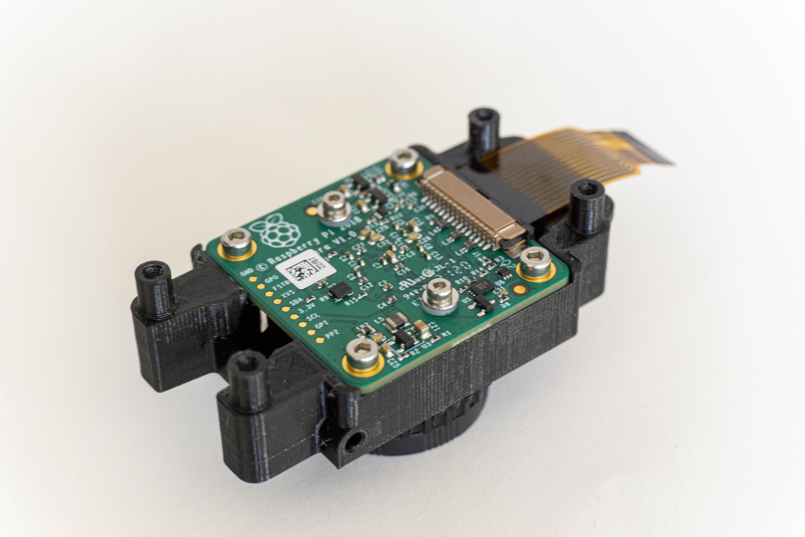
docs/_assets/assembly/119.jpg
