volzotan/CompressorCam/docs/_assets/assembly/200.jpg

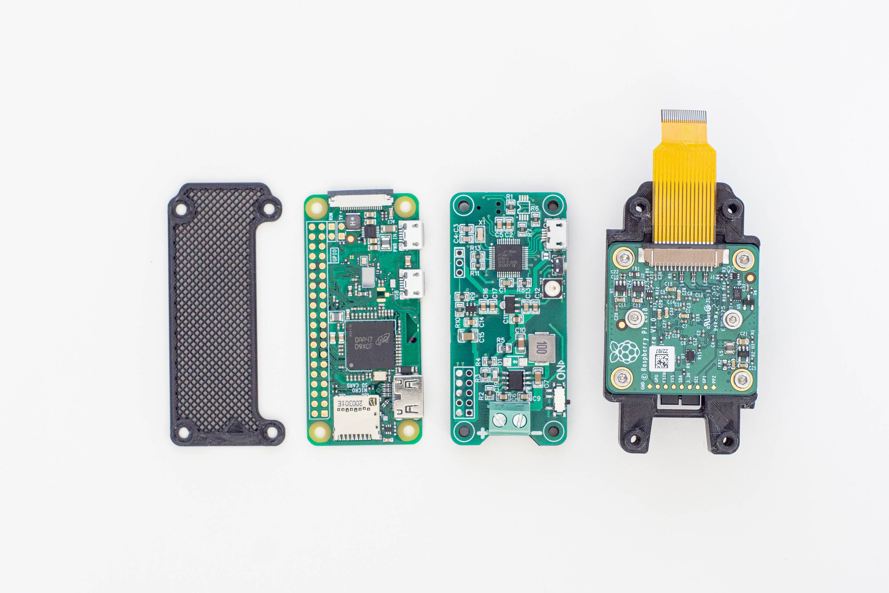
docs/_assets/assembly/200.jpg
