volzotan/CompressorCam/docs/_assets/assembly/201.jpg

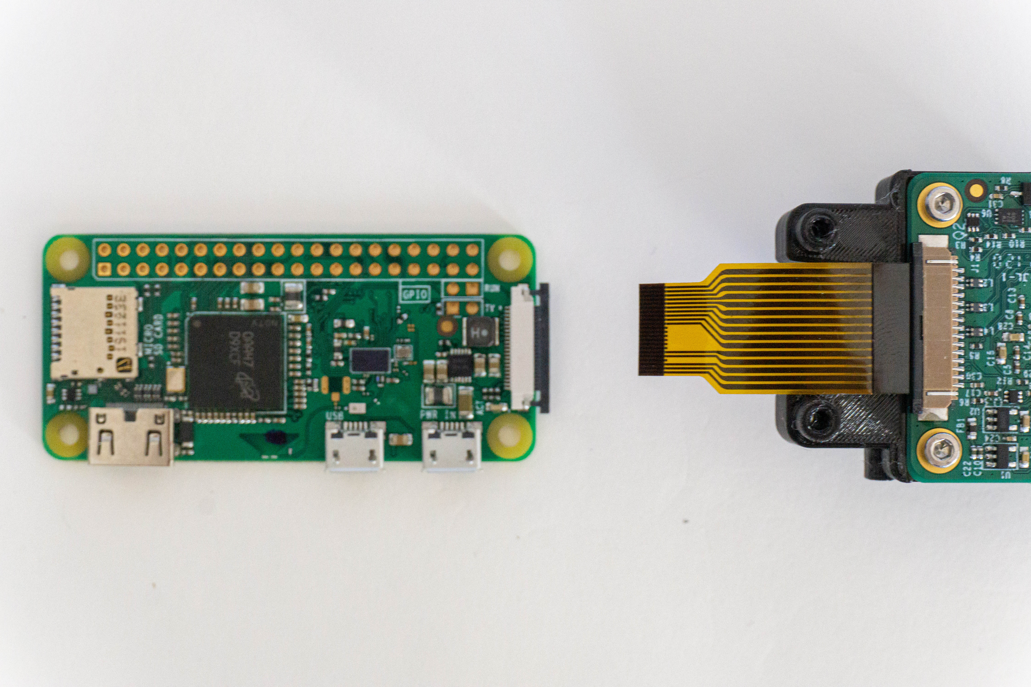
docs/_assets/assembly/201.jpg
