volzotan/CompressorCam/docs/_assets/assembly/202.jpg

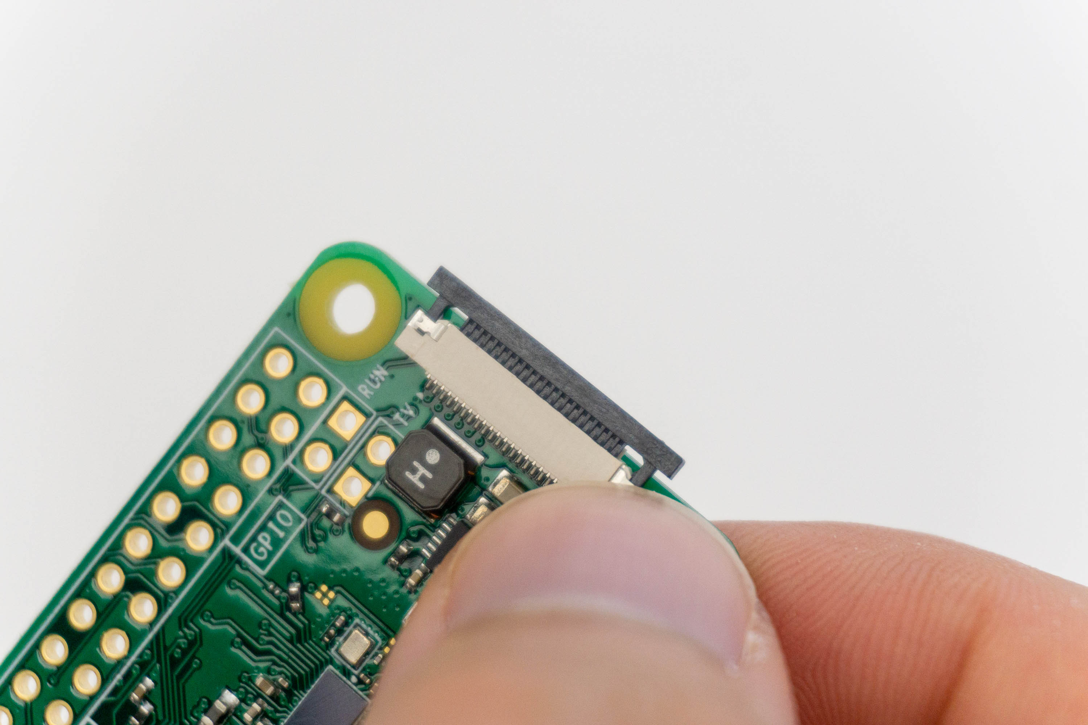
docs/_assets/assembly/202.jpg
