volzotan/CompressorCam/docs/_assets/assembly/203.jpg

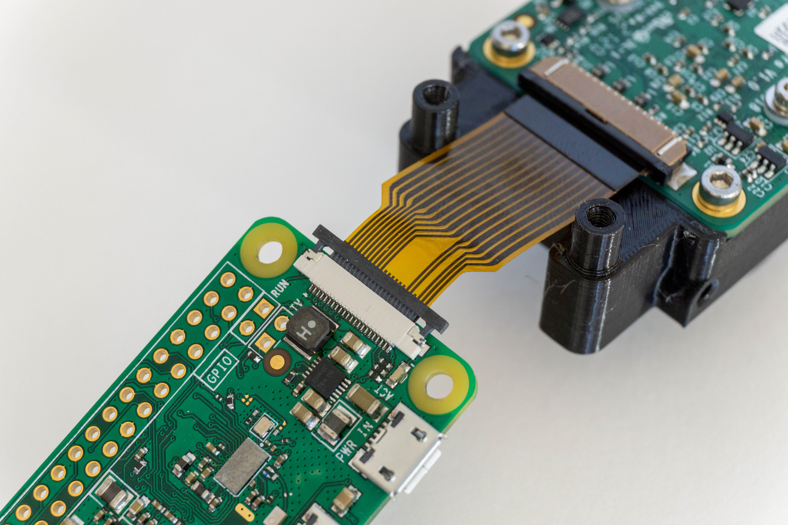
docs/_assets/assembly/203.jpg
