volzotan/CompressorCam/docs/_assets/assembly/204.jpg

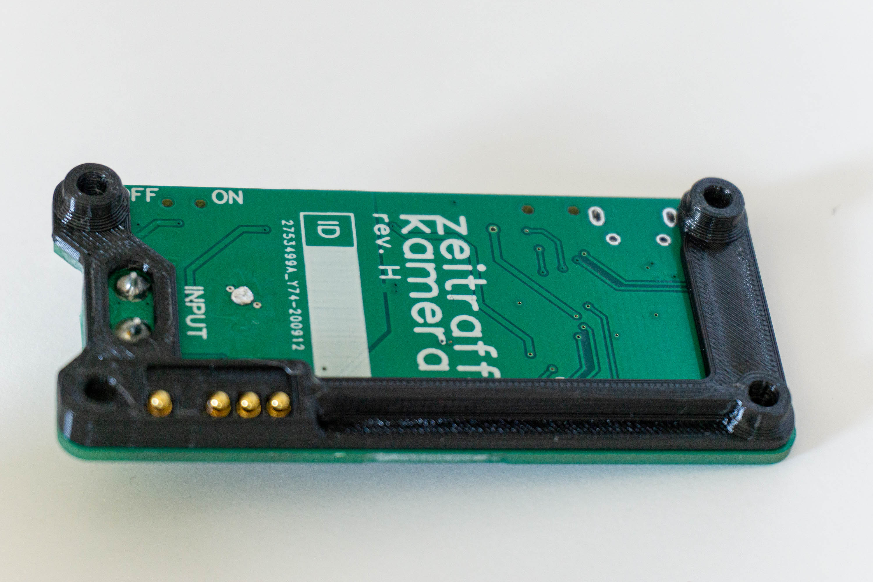
docs/_assets/assembly/204.jpg
