volzotan/CompressorCam/docs/_assets/assembly/205.jpg

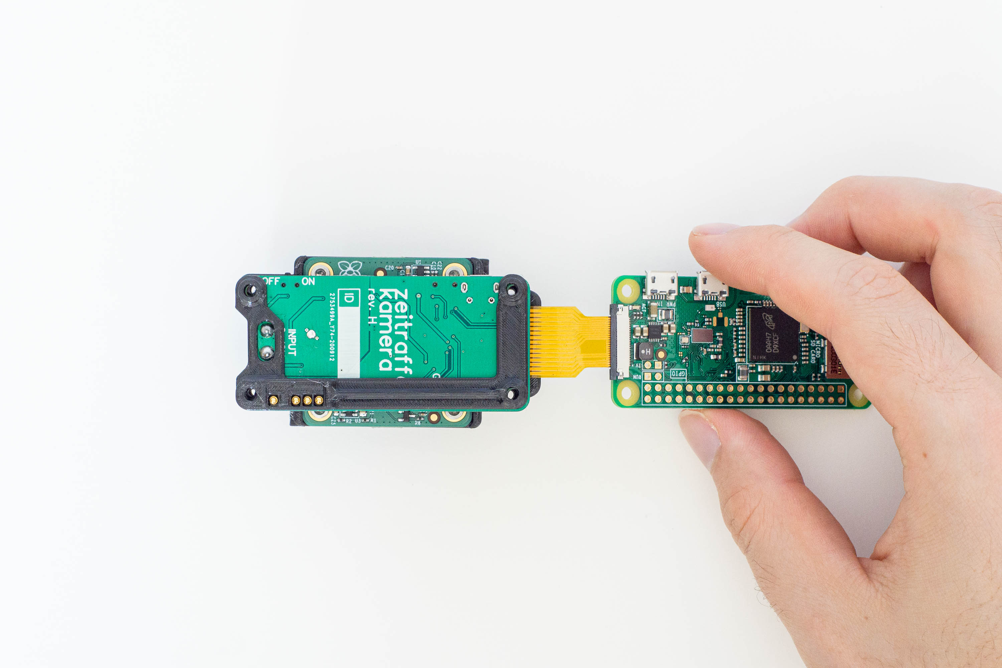
docs/_assets/assembly/205.jpg
