volzotan/CompressorCam/docs/_assets/assembly/206.jpg

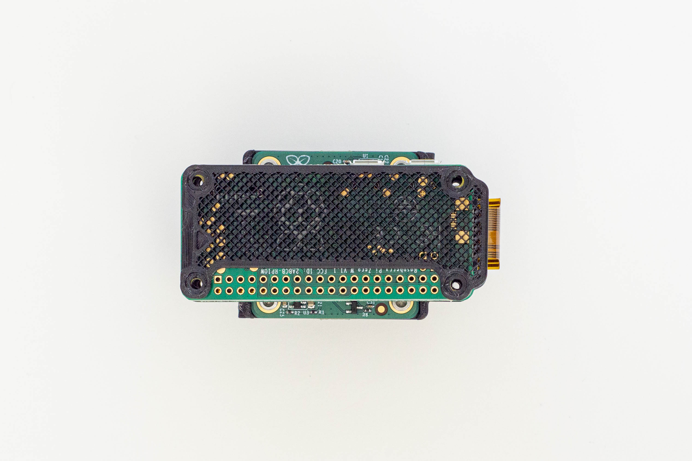
docs/_assets/assembly/206.jpg
