volzotan/CompressorCam/docs/_assets/assembly/208.jpg

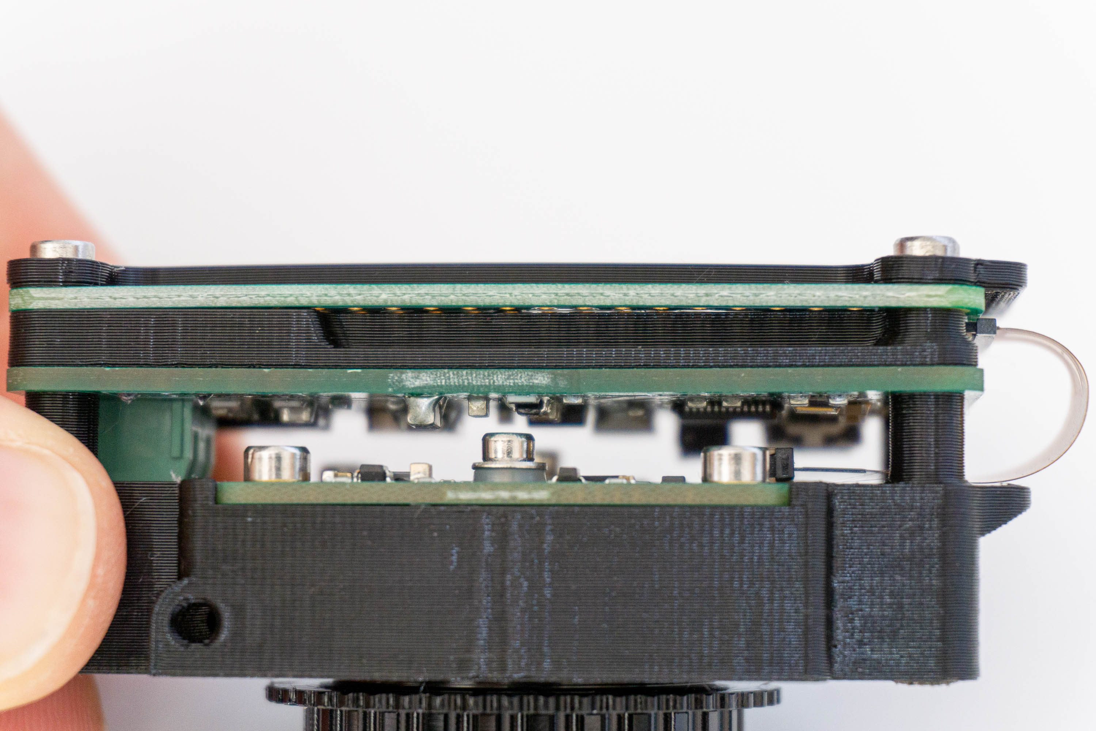
docs/_assets/assembly/208.jpg
