volzotan/CompressorCam/docs/_assets/assembly/209.jpg

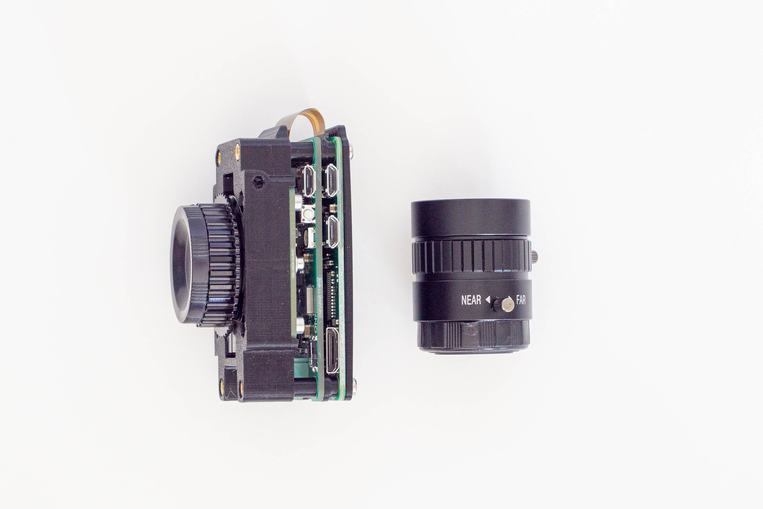
docs/_assets/assembly/209.jpg
