volzotan/CompressorCam/docs/_assets/assembly/210.jpg

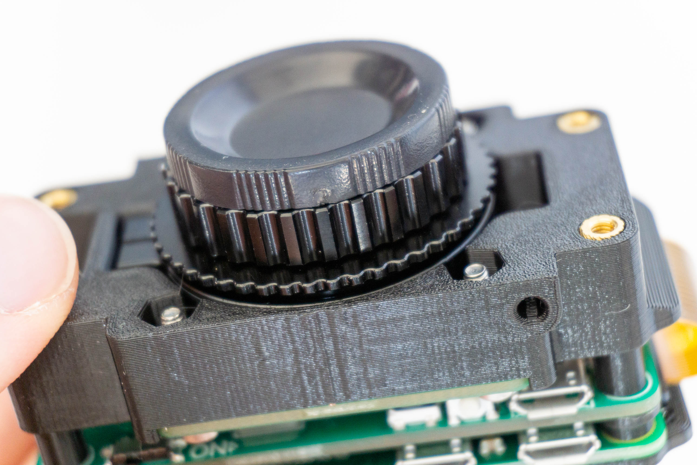
docs/_assets/assembly/210.jpg
