volzotan/CompressorCam/docs/_assets/assembly/211.jpg

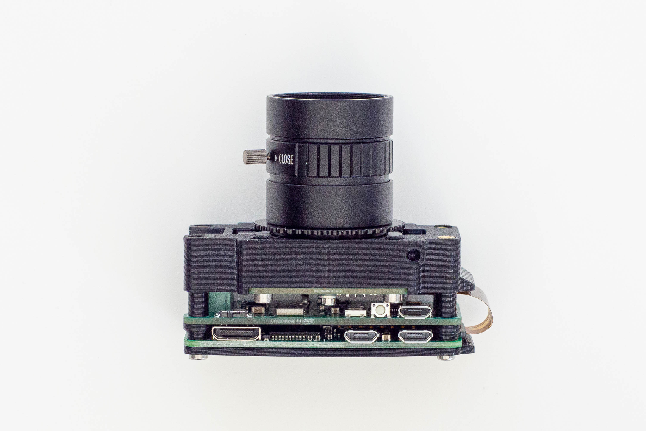
docs/_assets/assembly/211.jpg
