volzotan/CompressorCam/docs/_assets/assembly/220.jpg

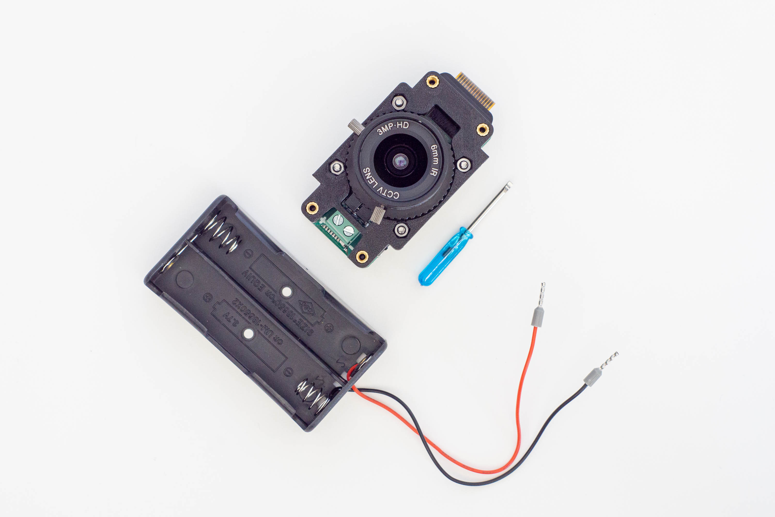
docs/_assets/assembly/220.jpg
