volzotan/CompressorCam/docs/_assets/assembly/221.jpg

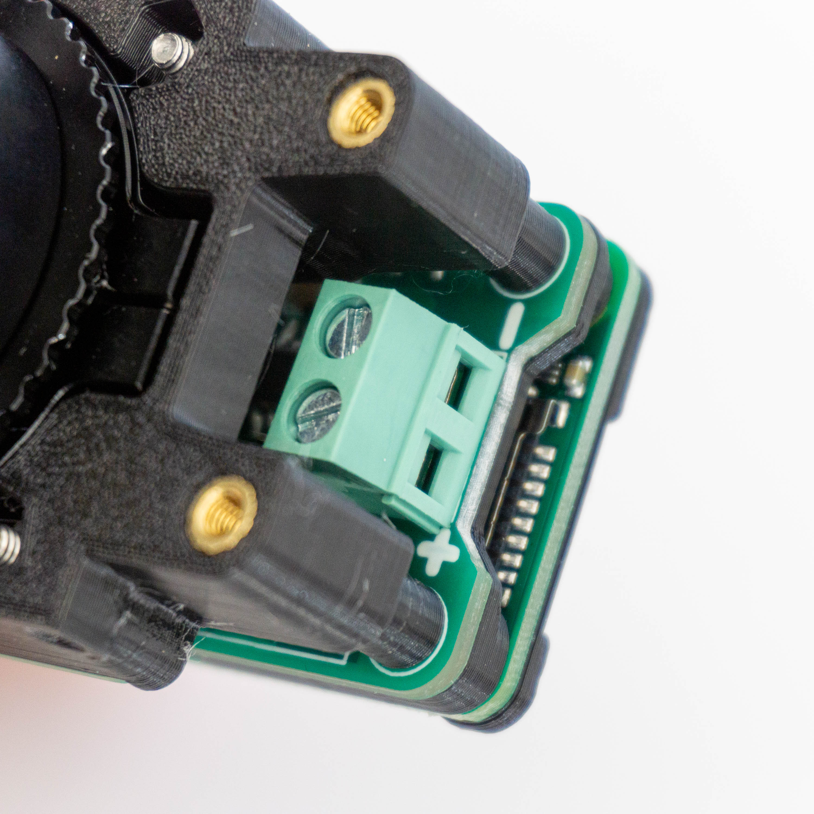
docs/_assets/assembly/221.jpg
