volzotan/CompressorCam/docs/_assets/assembly/222.jpg

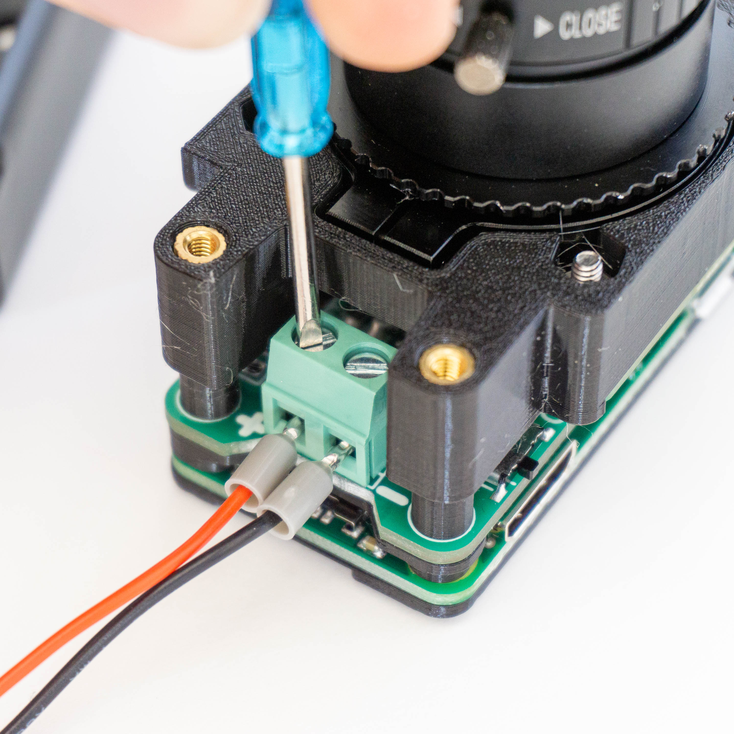
docs/_assets/assembly/222.jpg
