volzotan/CompressorCam/docs/_assets/assembly/223.jpg

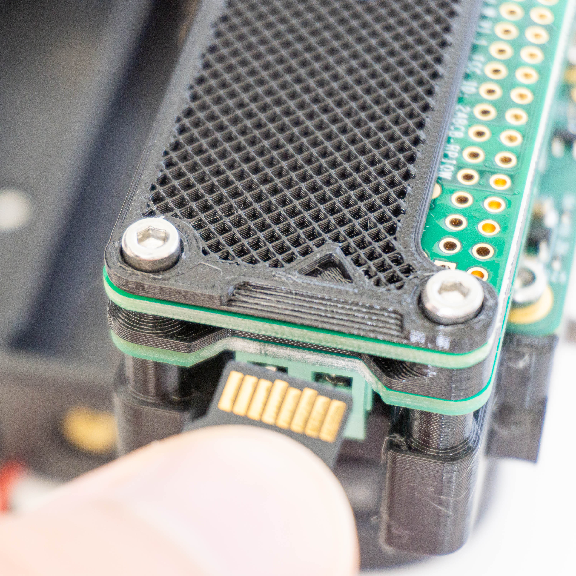
docs/_assets/assembly/223.jpg
