volzotan/CompressorCam/docs/_assets/assembly/224.jpg

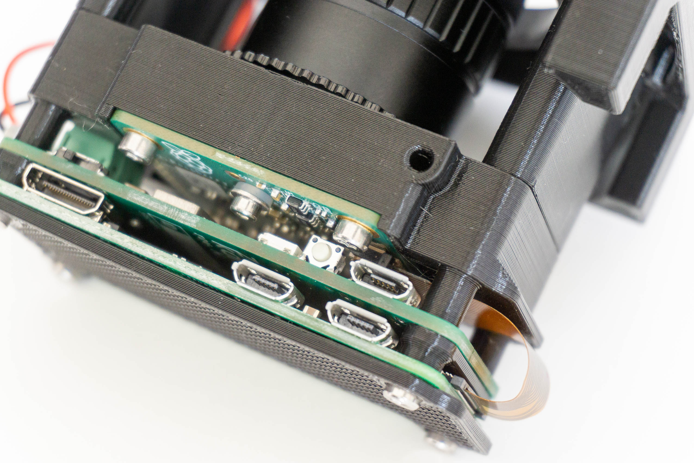
docs/_assets/assembly/224.jpg
