volzotan/CompressorCam/docs/_assets/assembly/225.jpg

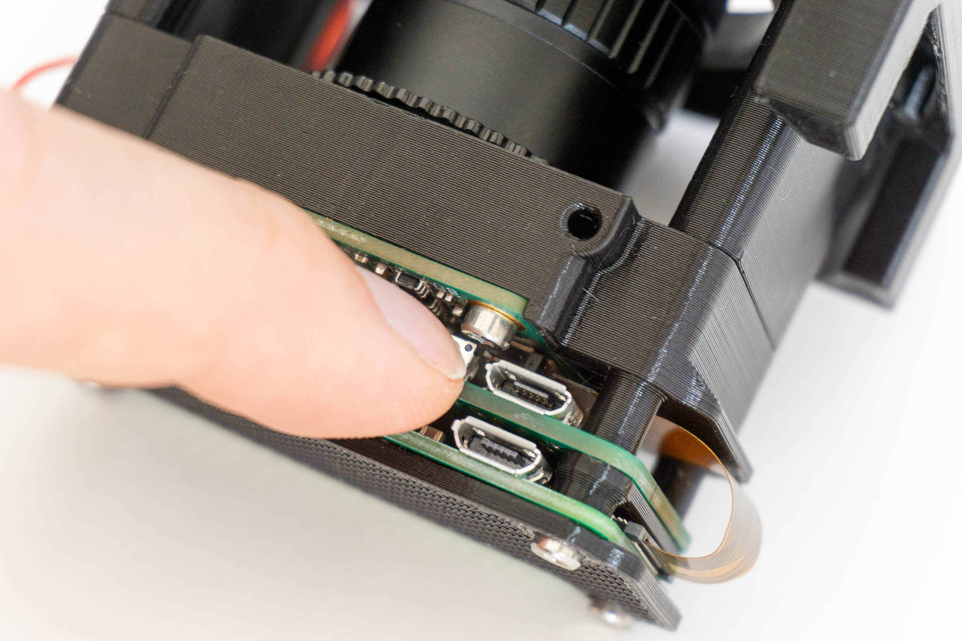
docs/_assets/assembly/225.jpg
