volzotan/CompressorCam/docs/_assets/assembly/226.jpg

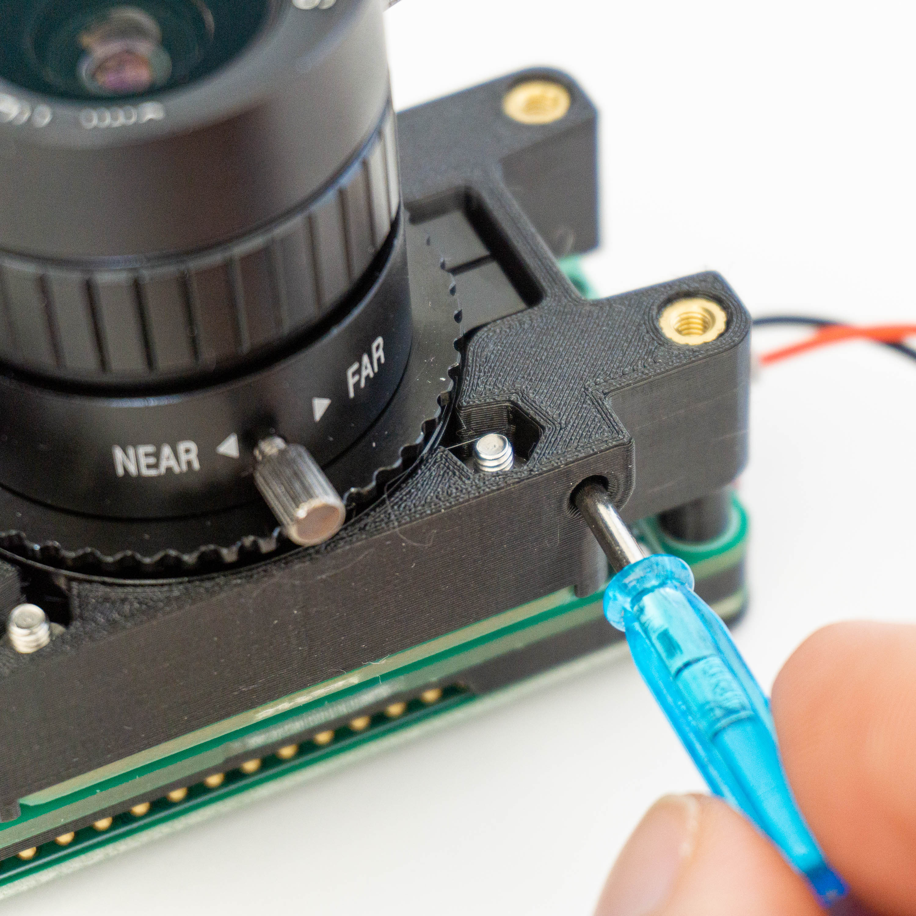
docs/_assets/assembly/226.jpg
