volzotan/CompressorCam/docs/_assets/assembly/300.jpg

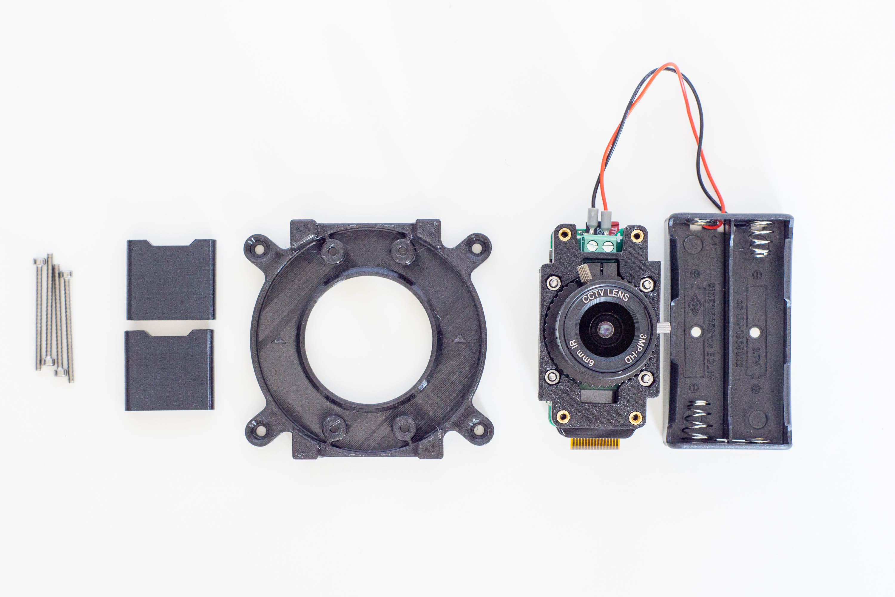
docs/_assets/assembly/300.jpg
