volzotan/CompressorCam/docs/_assets/assembly/301.jpg

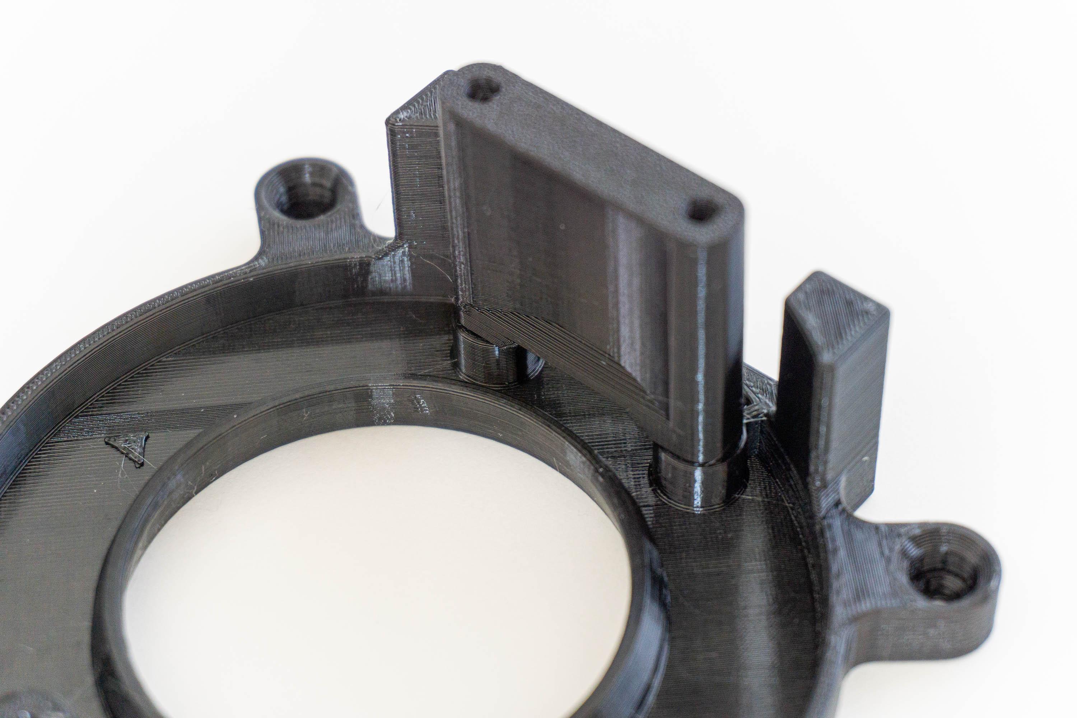
docs/_assets/assembly/301.jpg
