volzotan/CompressorCam/docs/_assets/assembly/302.jpg

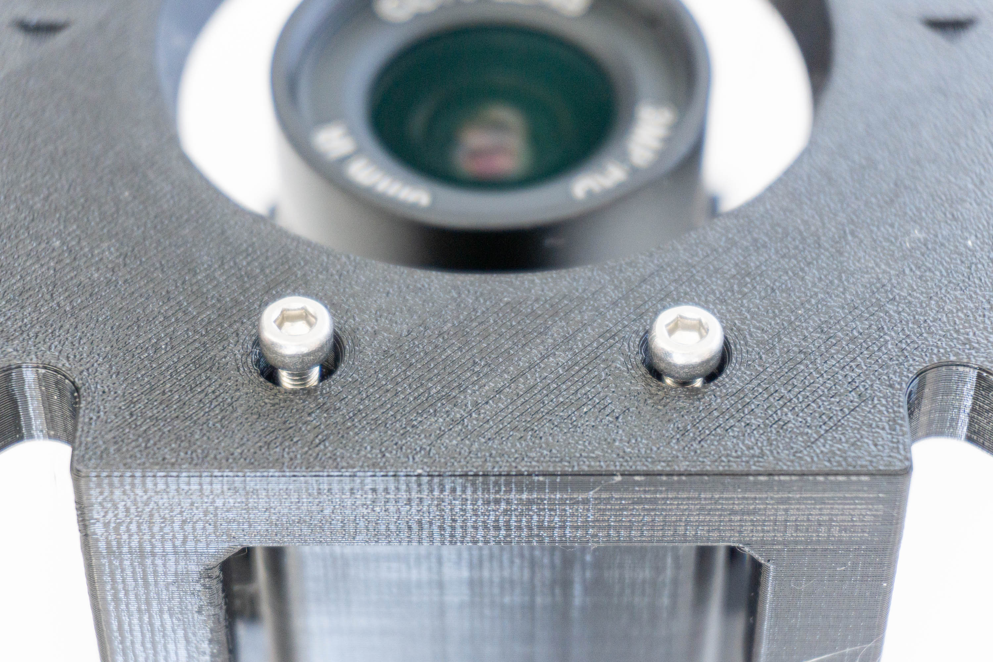
docs/_assets/assembly/302.jpg
