volzotan/CompressorCam/docs/_assets/assembly/303.jpg

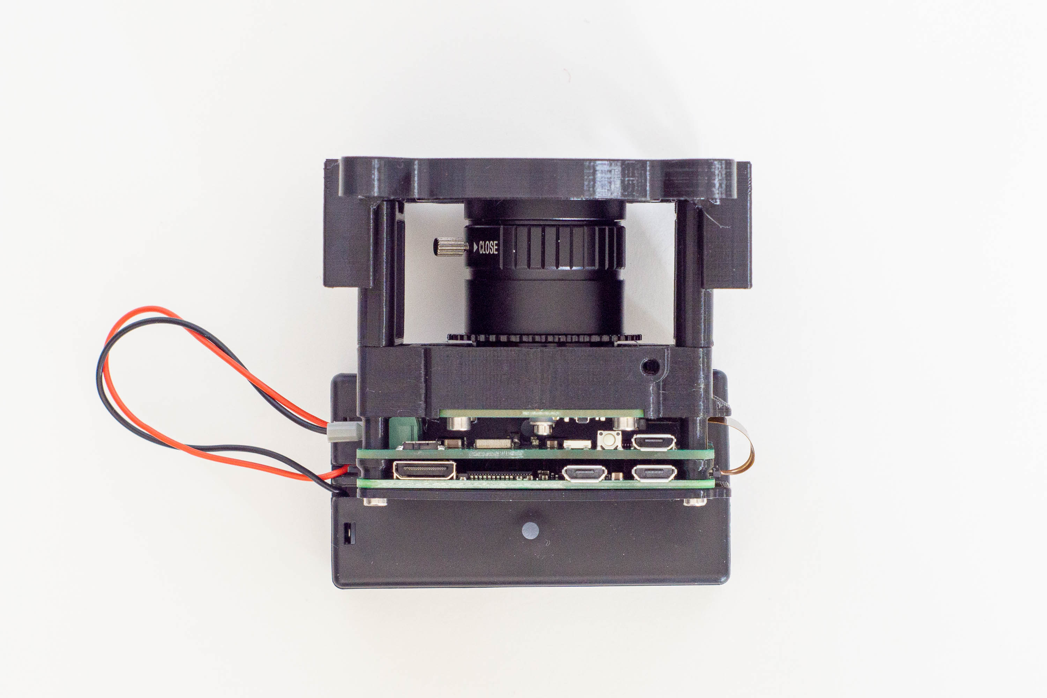
docs/_assets/assembly/303.jpg
