volzotan/CompressorCam/docs/_assets/assembly/310.jpg

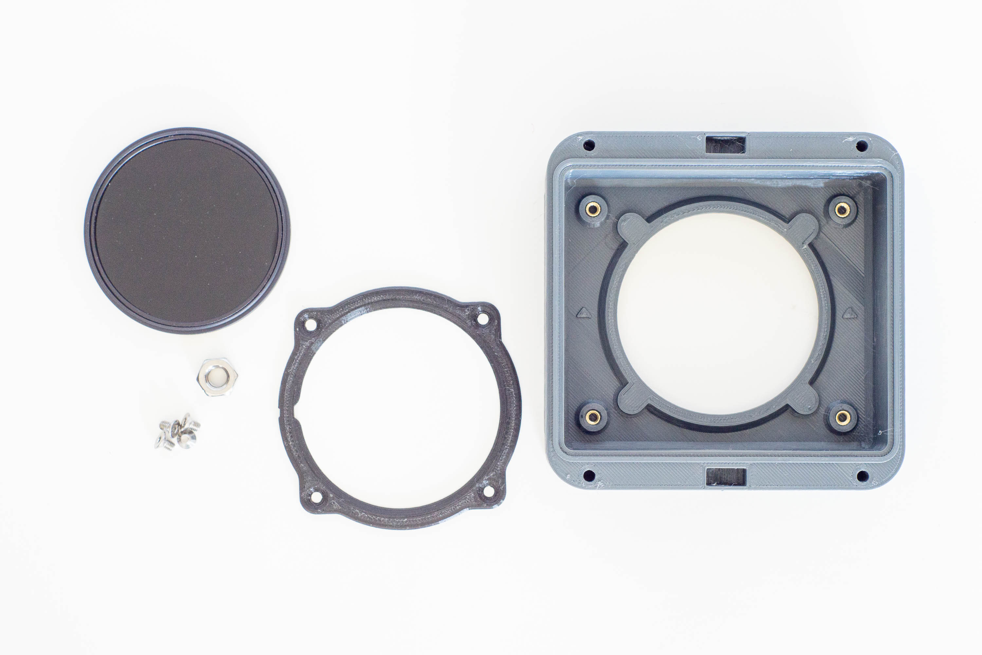
docs/_assets/assembly/310.jpg
