volzotan/CompressorCam/docs/_assets/assembly/311.jpg

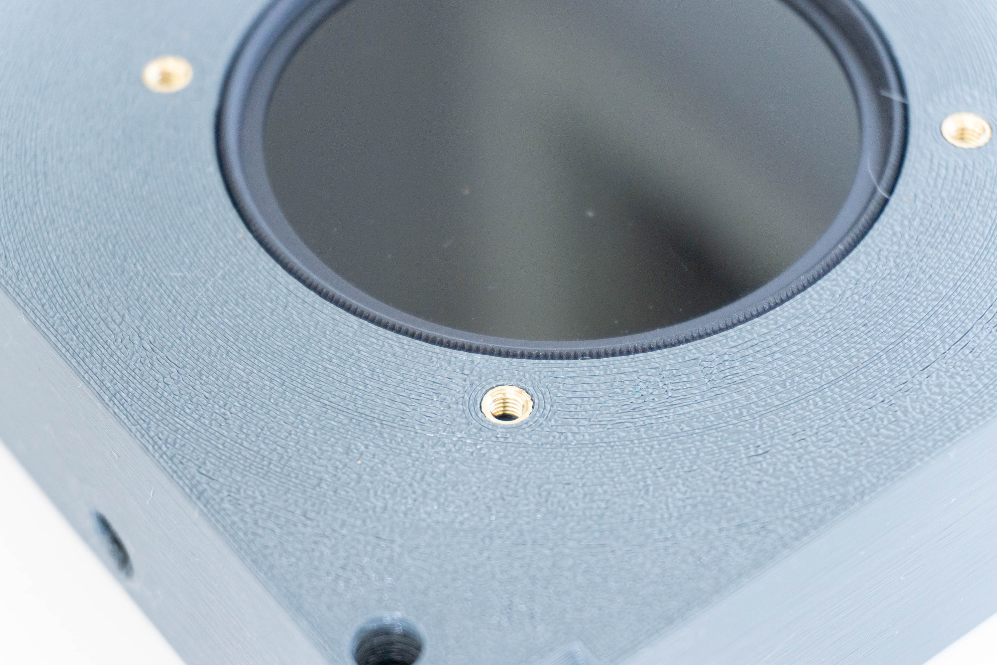
docs/_assets/assembly/311.jpg
