volzotan/CompressorCam/docs/_assets/assembly/312.jpg

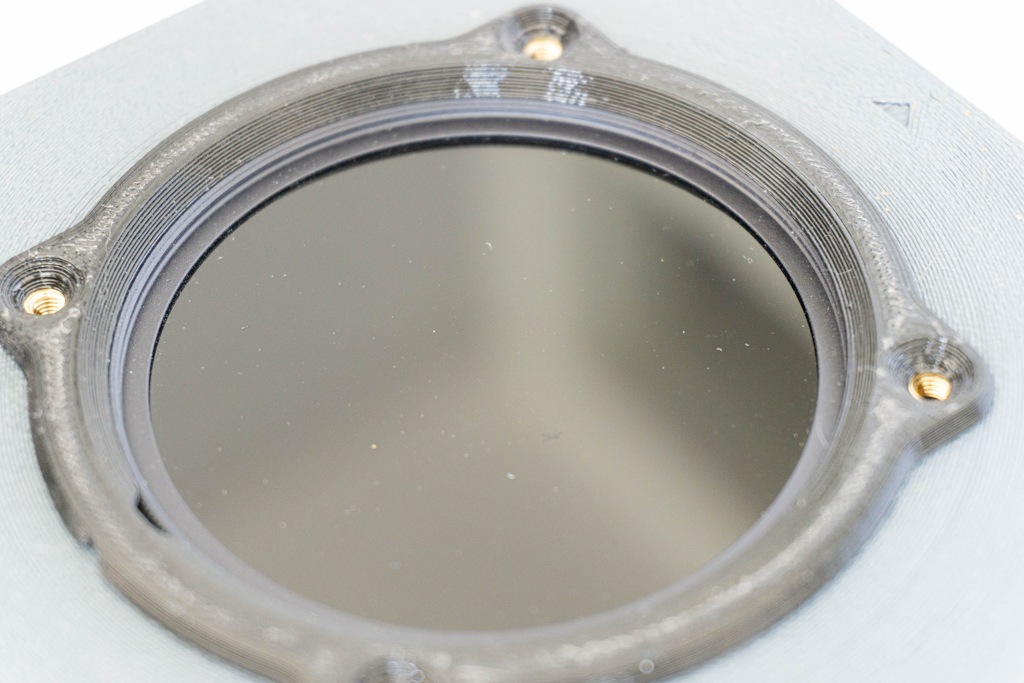
docs/_assets/assembly/312.jpg
