volzotan/CompressorCam/docs/_assets/assembly/313.jpg

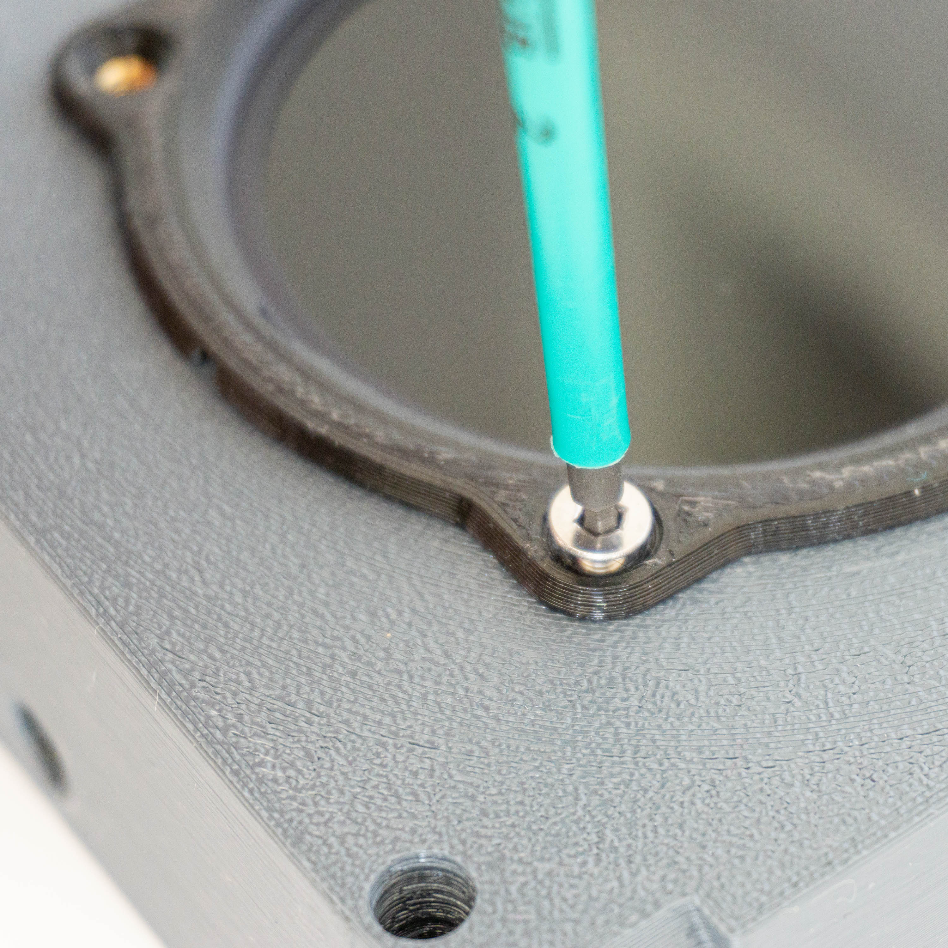
docs/_assets/assembly/313.jpg
