volzotan/CompressorCam/docs/_assets/assembly/314.jpg

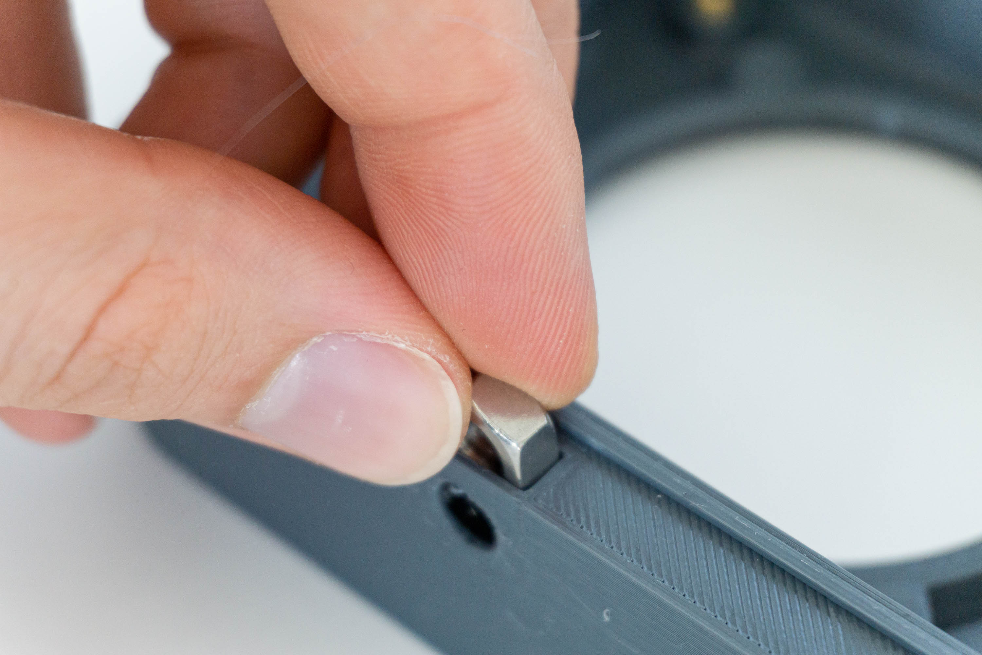
docs/_assets/assembly/314.jpg
