volzotan/CompressorCam/docs/_assets/assembly/315.jpg

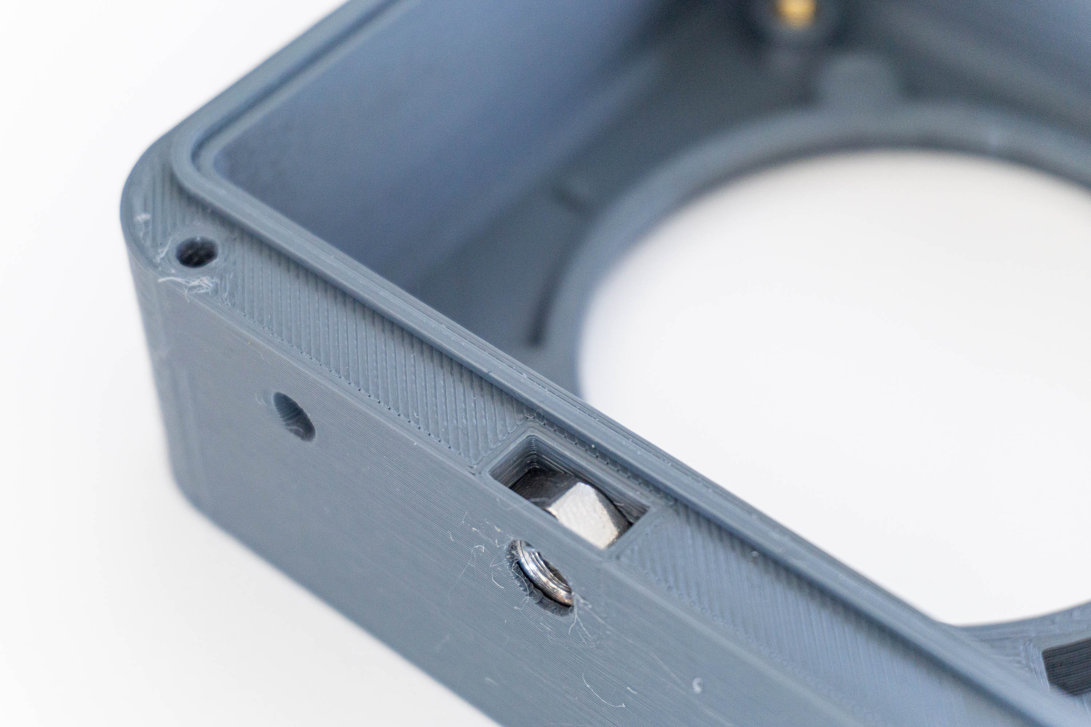
docs/_assets/assembly/315.jpg
