volzotan/CompressorCam/docs/_assets/assembly/320.jpg

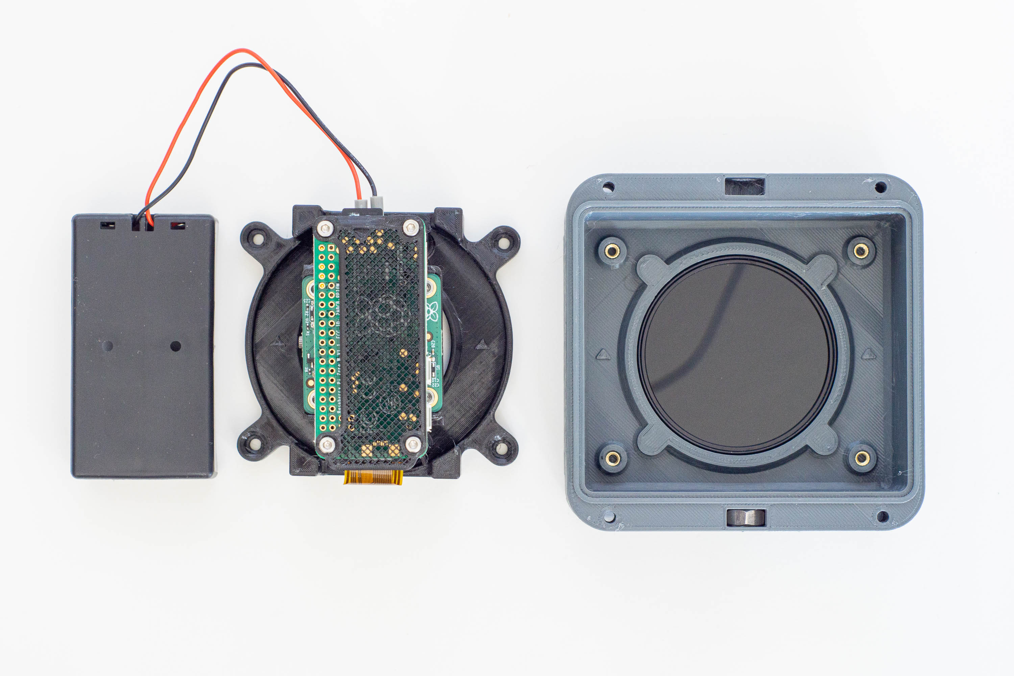
docs/_assets/assembly/320.jpg
