volzotan/CompressorCam/docs/_assets/assembly/321.jpg

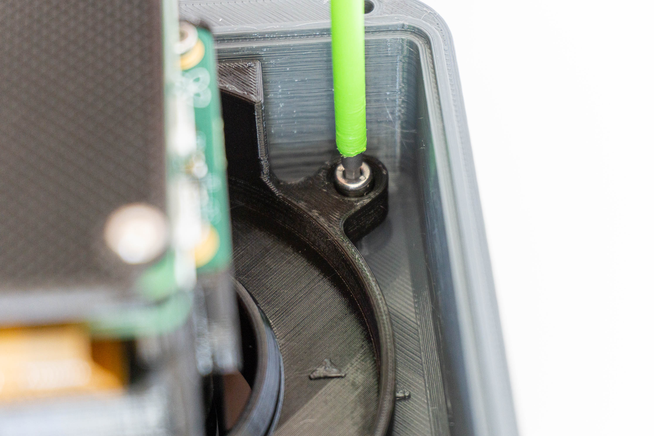
docs/_assets/assembly/321.jpg
