volzotan/CompressorCam/docs/_assets/assembly/322.jpg

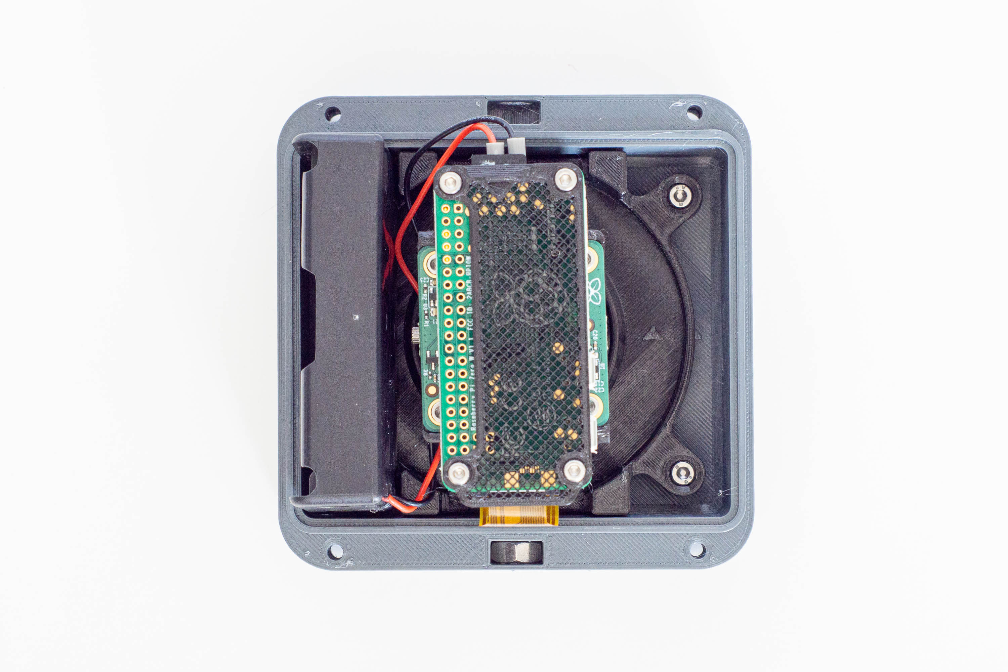
docs/_assets/assembly/322.jpg
