volzotan/CompressorCam/docs/_assets/assembly/323.jpg

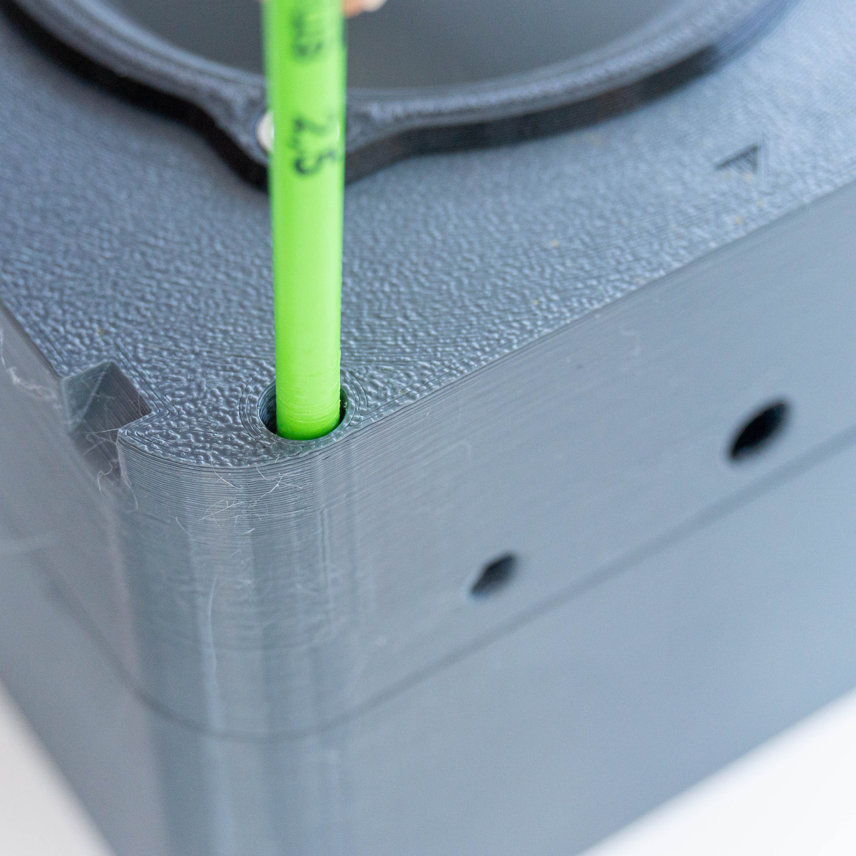
docs/_assets/assembly/323.jpg
