volzotan/CompressorCam/docs/_assets/assembly/2051.jpg

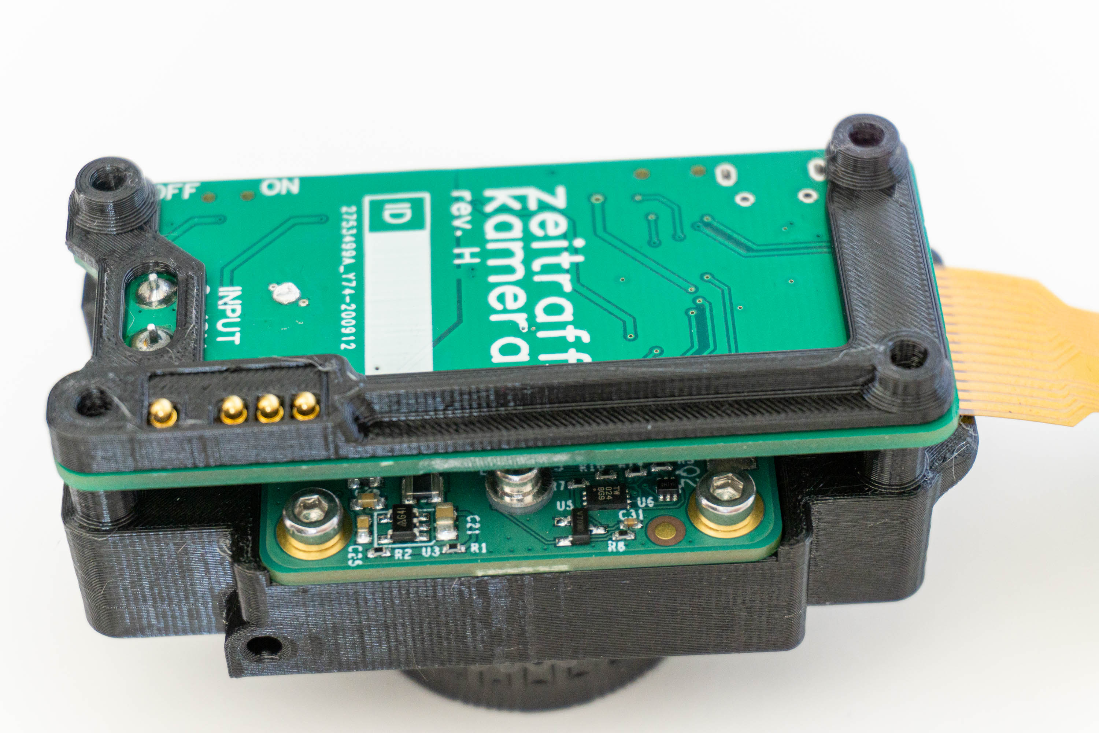
docs/_assets/assembly/2051.jpg
