volzotan/CompressorCam/docs/_assets/assembly/2052.jpg

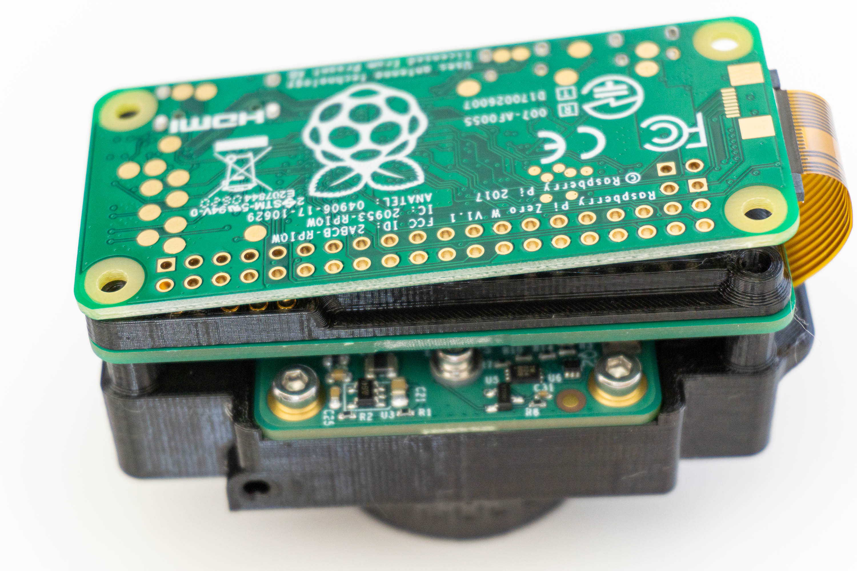
docs/_assets/assembly/2052.jpg
