volzotan/CompressorCam/docs/_assets/assembly/2053.jpg

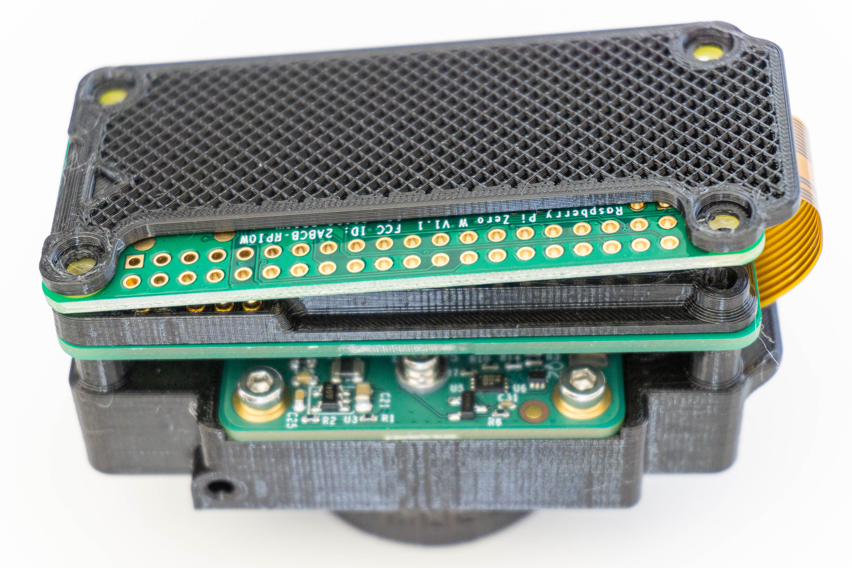
docs/_assets/assembly/2053.jpg
