volzotan/CompressorCam/docs/_assets/assembly/2054.jpg

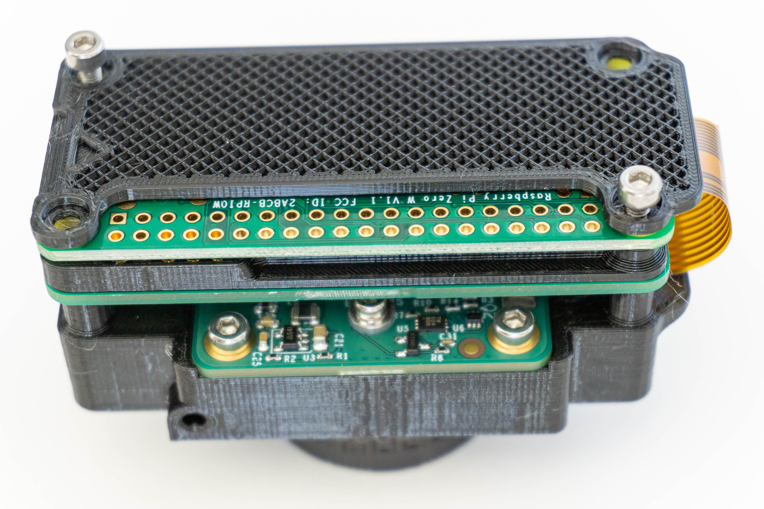
docs/_assets/assembly/2054.jpg
