volzotan/CompressorCam/docs/_assets/assembly/2055.jpg

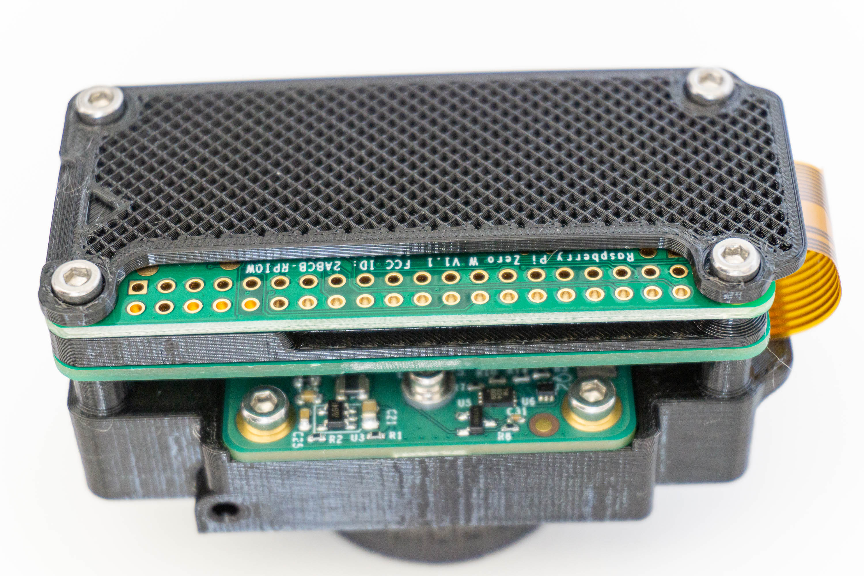
docs/_assets/assembly/2055.jpg
