volzotan/CompressorCam/docs/_assets/assembly/application_screenshot.png

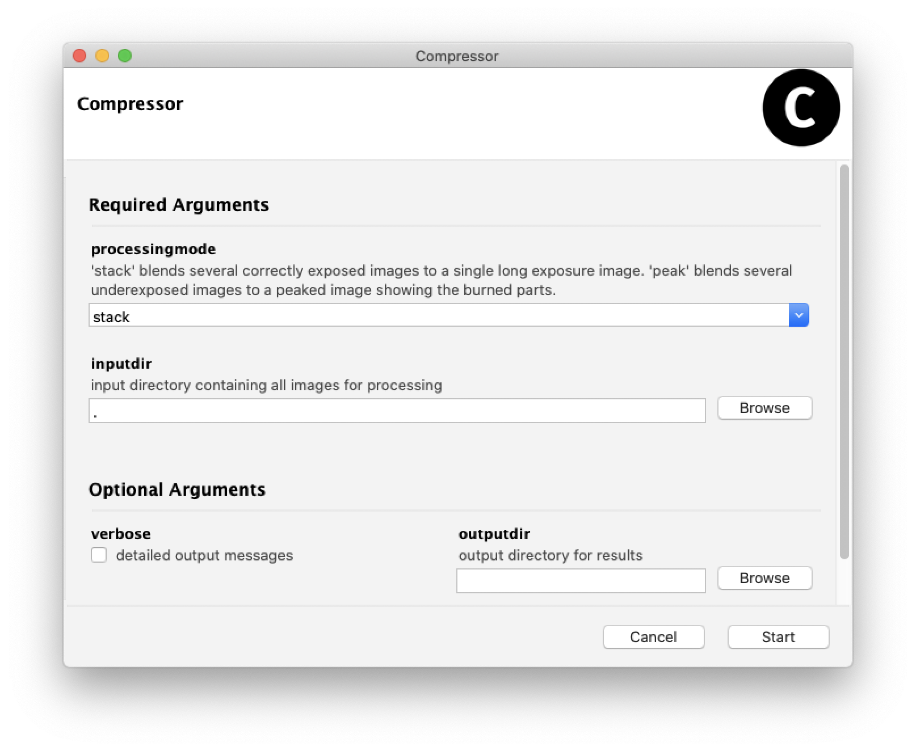
docs/_assets/assembly/application_screenshot.png
