volzotan/CompressorCam/docs/_assets/assembly/battery_leads.jpg

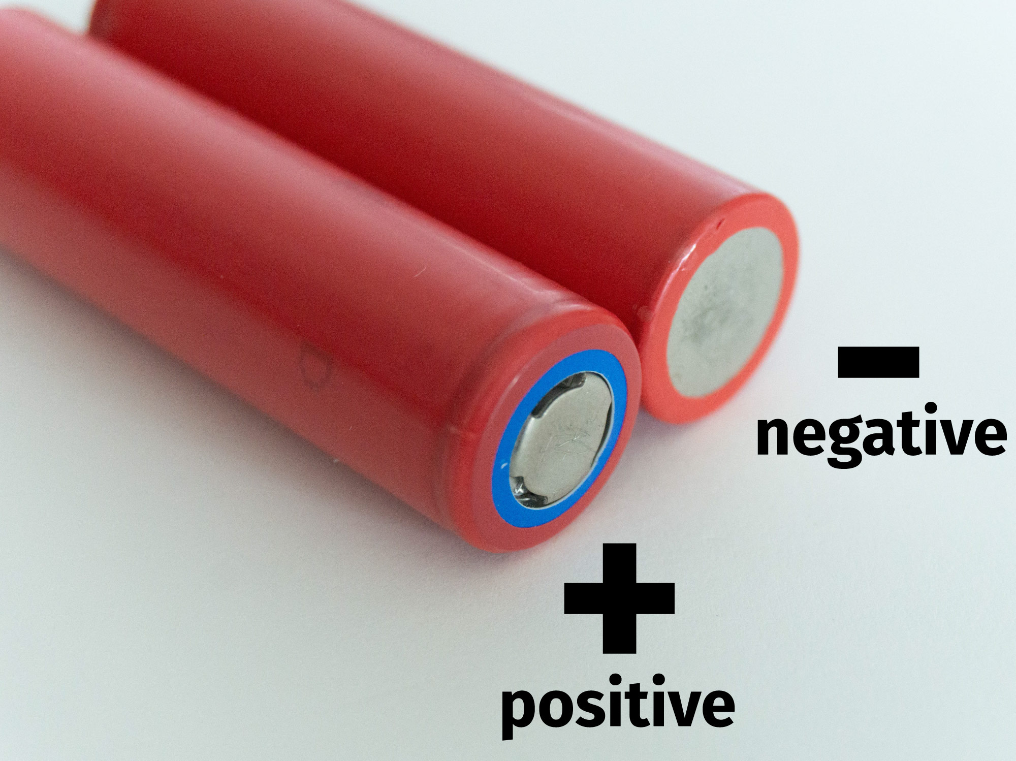
docs/_assets/assembly/battery_leads.jpg
