volzotan/CompressorCam/docs/_assets/assembly/button_explanations.png

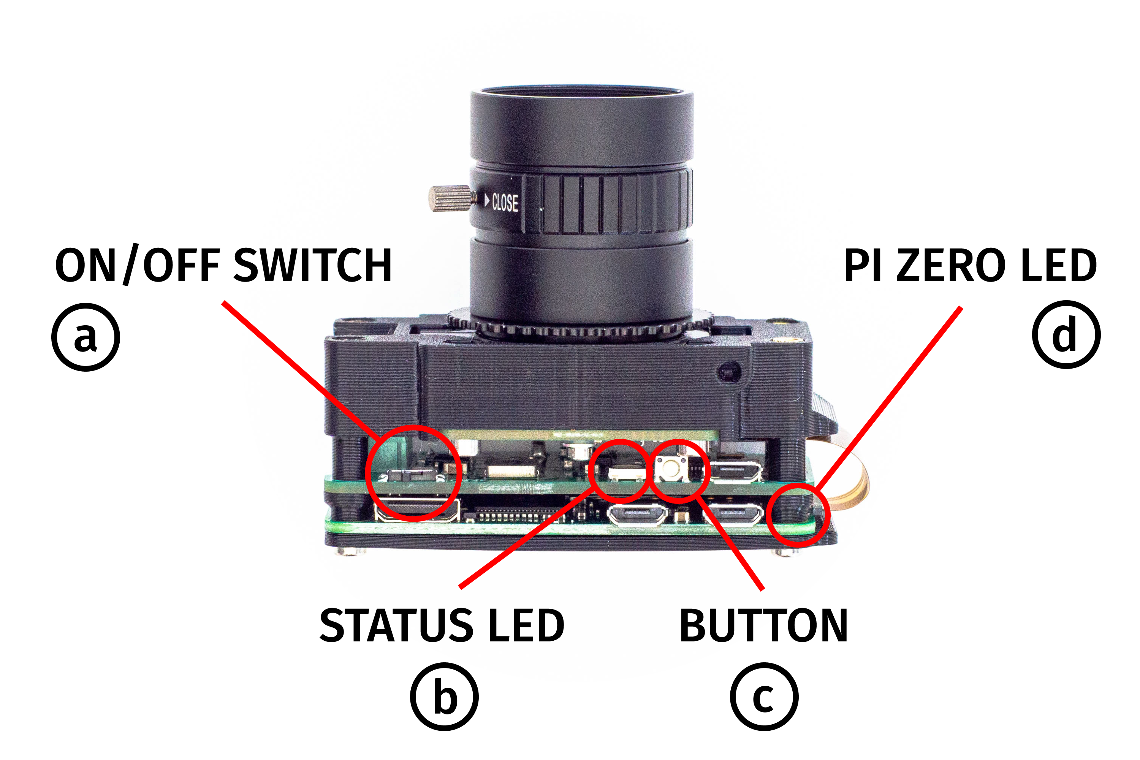
docs/_assets/assembly/button_explanations.png
