volzotan/CompressorCam/docs/_assets/assembly/example_marktplatz_1.jpg

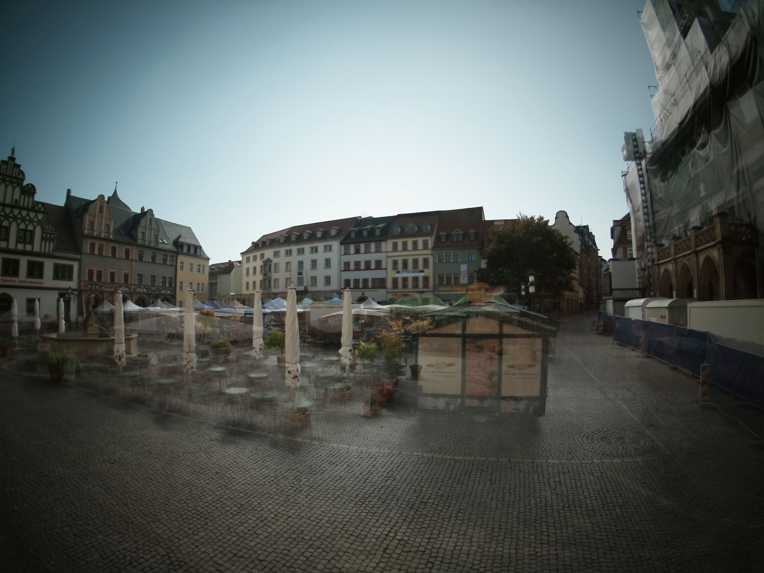
docs/_assets/assembly/example_marktplatz_1.jpg
