volzotan/CompressorCam/docs/_assets/assembly/example_marktplatz_2.jpg

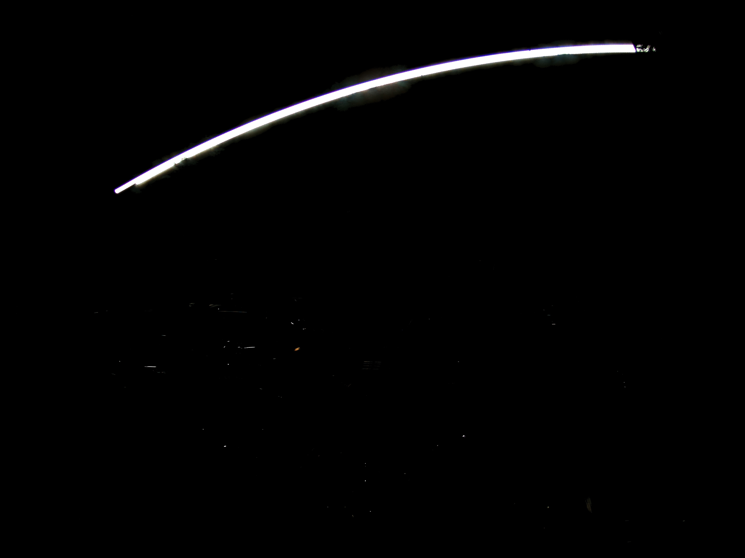
docs/_assets/assembly/example_marktplatz_2.jpg
