volzotan/CompressorCam/docs/_assets/assembly/led_status.png

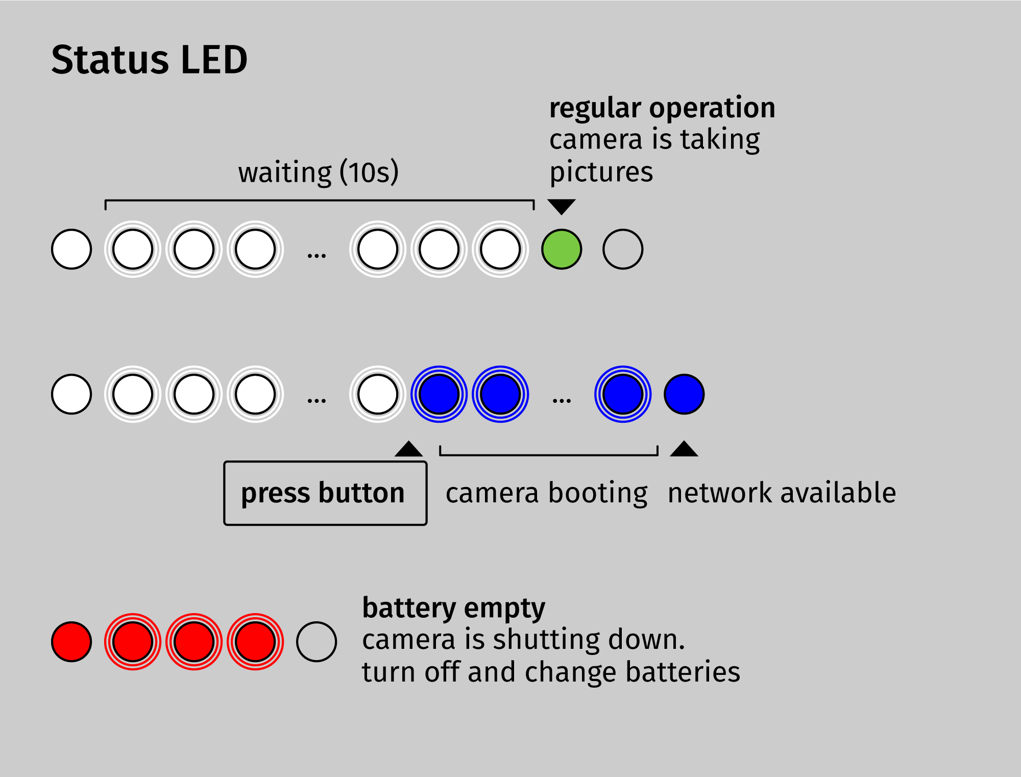
docs/_assets/assembly/led_status.png
