volzotan/CompressorCam/docs/_assets/assembly/lens_explanation.jpg

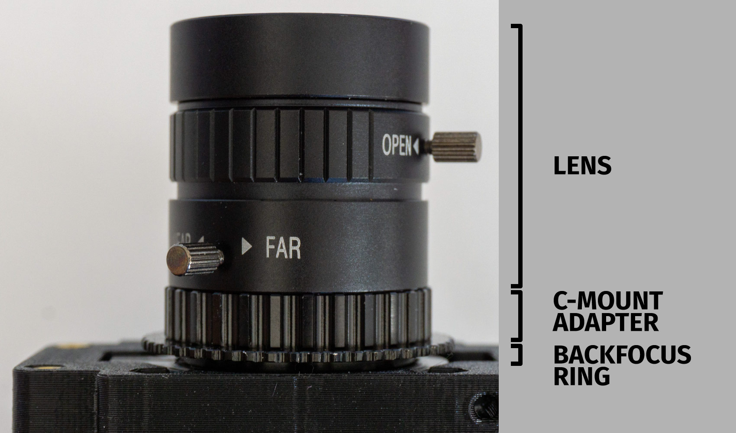
docs/_assets/assembly/lens_explanation.jpg
