volzotan/CompressorCam/docs/_assets/assembly/lumos_screenshot.jpg

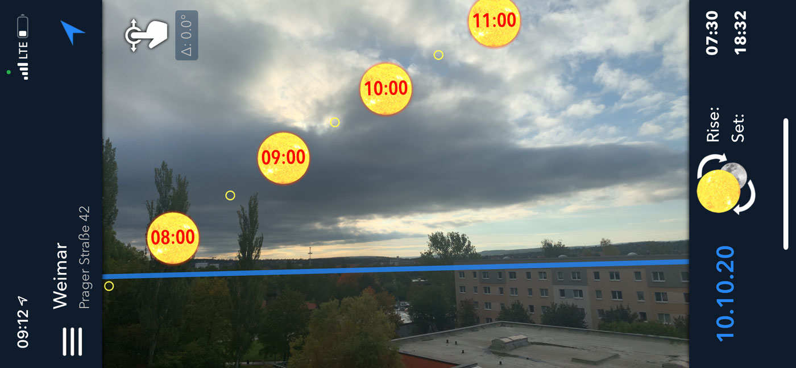
docs/_assets/assembly/lumos_screenshot.jpg
