volzotan/CompressorCam/docs/_assets/assembly/pi_act_led.jpg

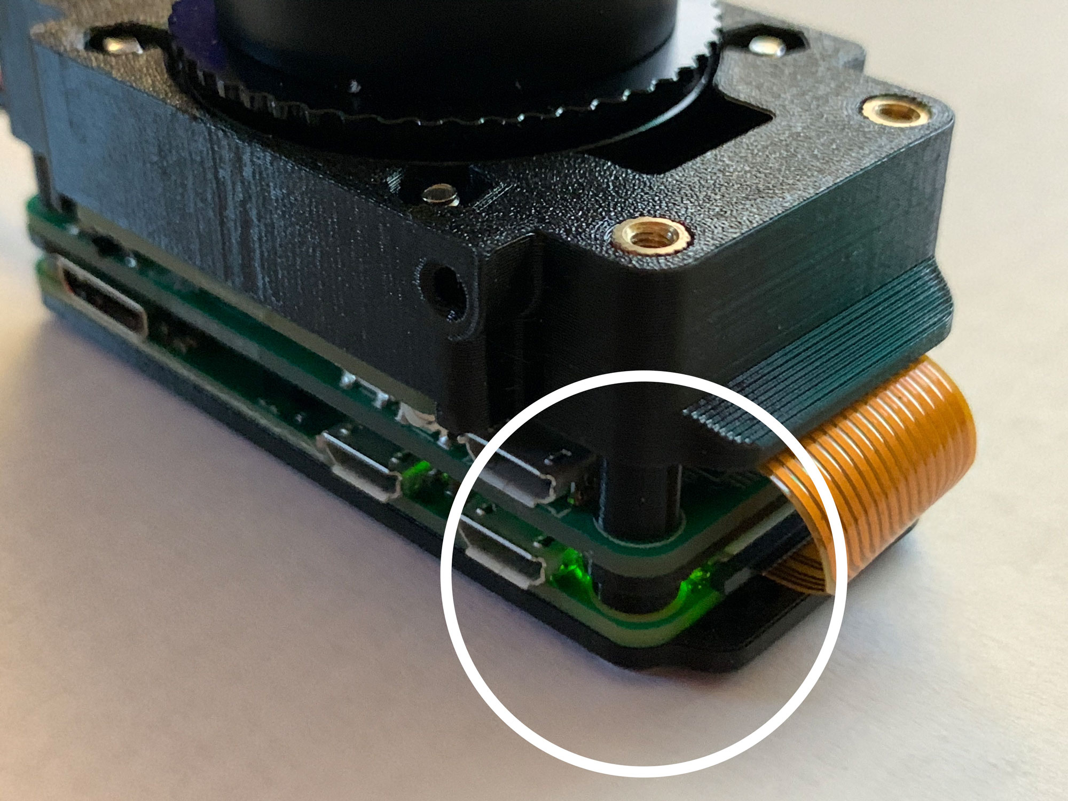
docs/_assets/assembly/pi_act_led.jpg
