volzotan/CompressorCam/docs/_assets/assembly/webinterface_screenshot.png

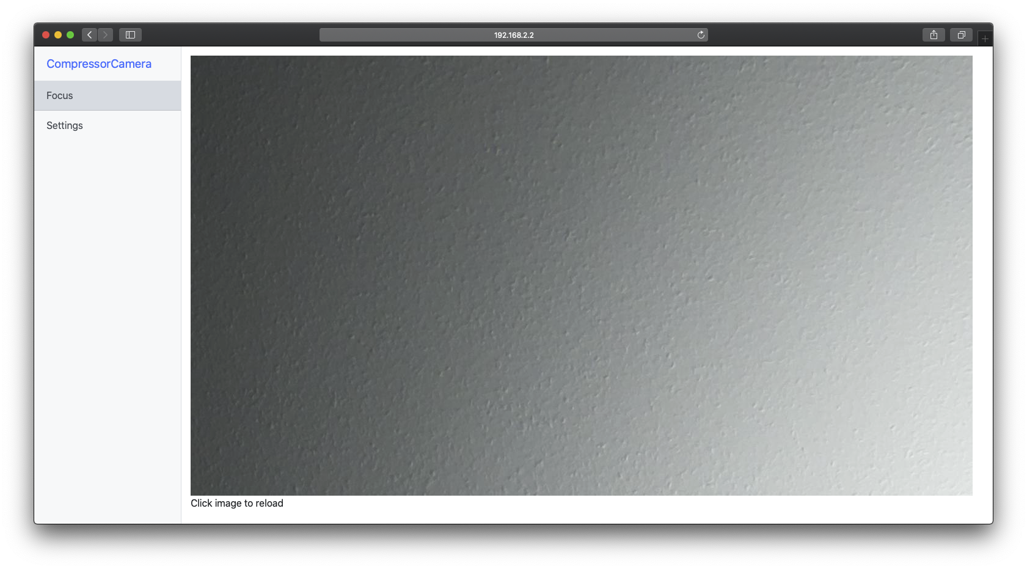
docs/_assets/assembly/webinterface_screenshot.png
