volzotan/CompressorCam/docs/_assets/guides/balena_etcher_screenshot.png

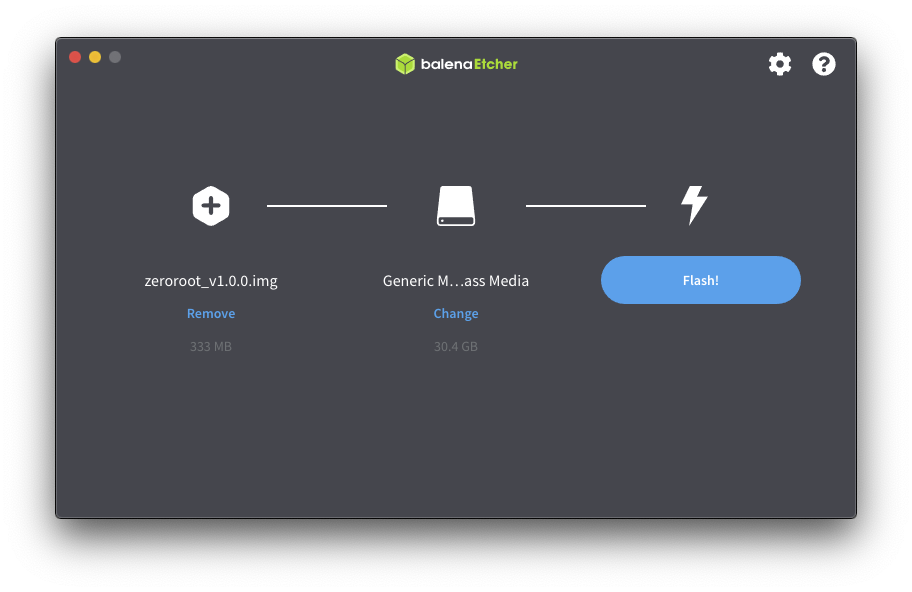
docs/_assets/guides/balena_etcher_screenshot.png
