volzotan/CompressorCam/docs/assets/assembly/110.jpg

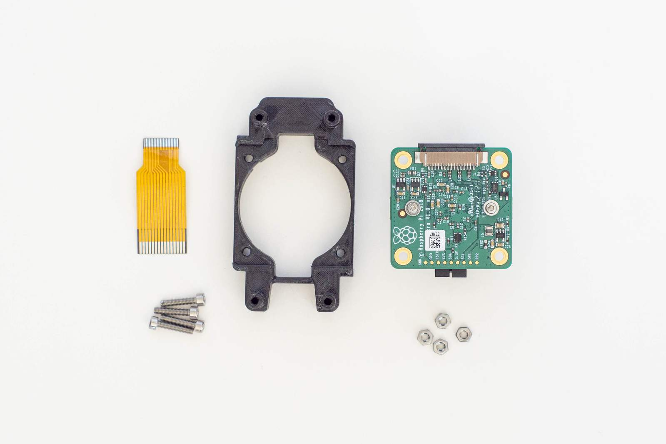
docs/assets/assembly/110.jpg
