volzotan/CompressorCam/docs/assets/assembly/202.jpg

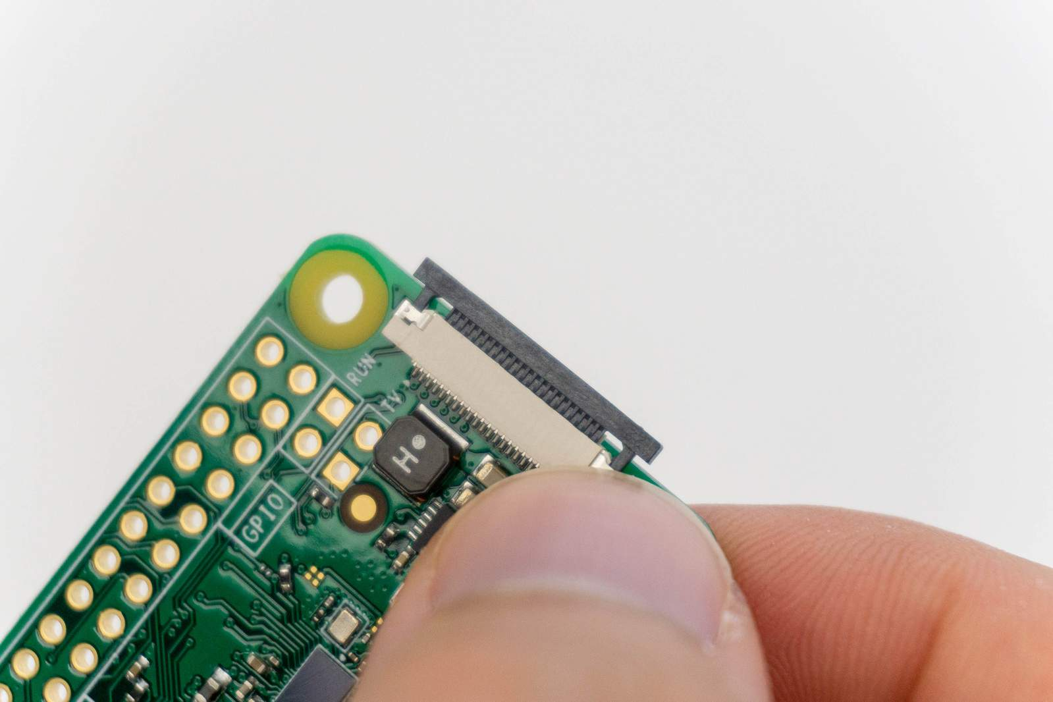
docs/assets/assembly/202.jpg
