volzotan/CompressorCam/docs/assets/assembly/208.jpg

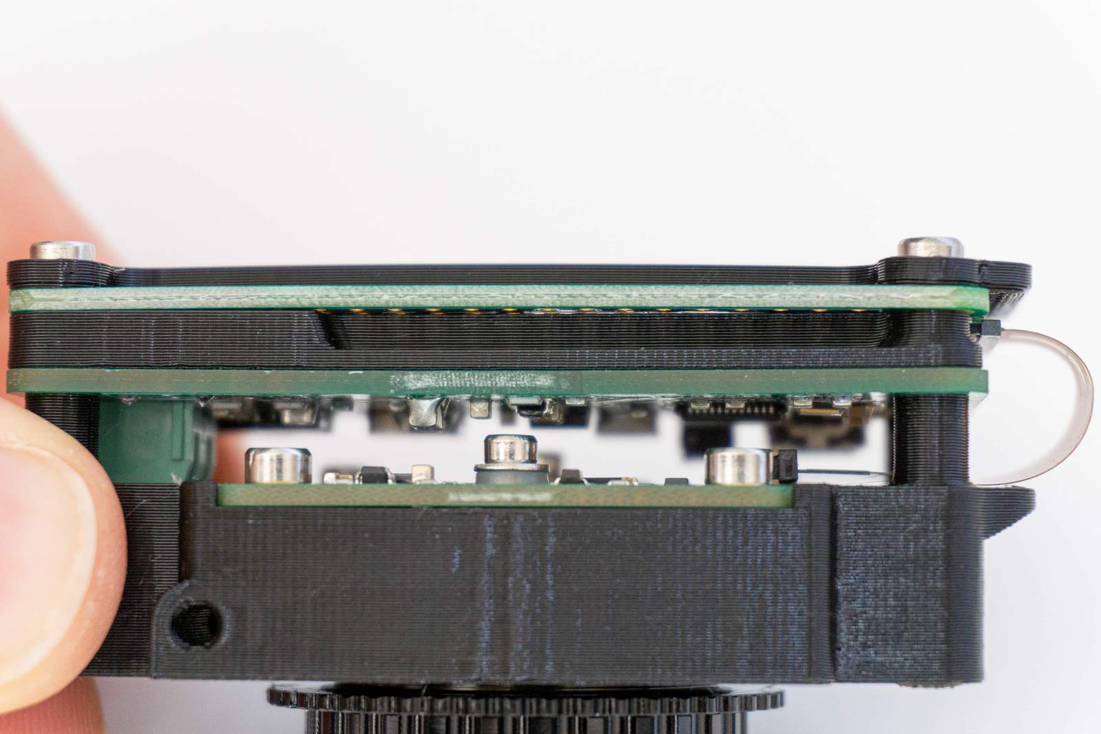
docs/assets/assembly/208.jpg
