volzotan/CompressorCam/docs/assets/assembly/300.jpg

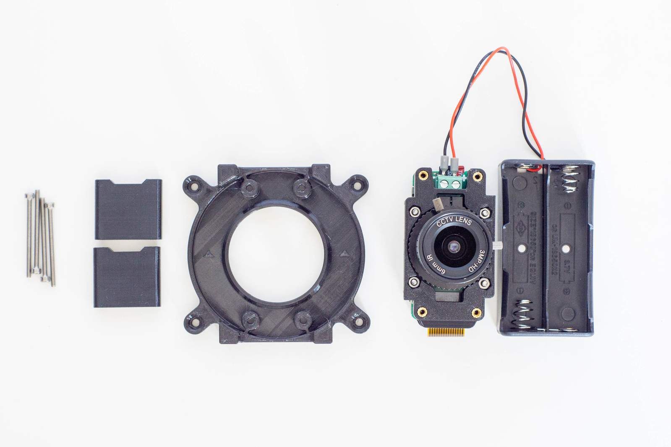
docs/assets/assembly/300.jpg
