volzotan/CompressorCam/docs/assets_scaled/assembly/322.jpg

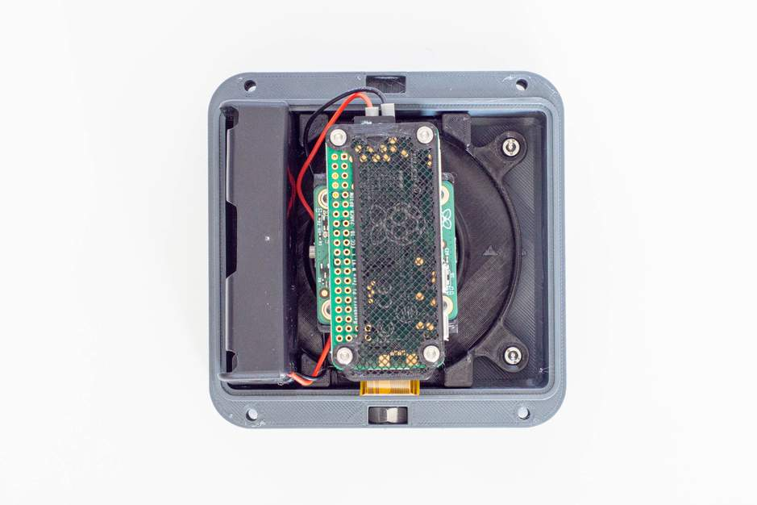
docs/assets_scaled/assembly/322.jpg
