volzotan/CompressorCam/hardware/gerbers/CompressorCamRevJ/Schematic_CompressorCamRevJ.pdf

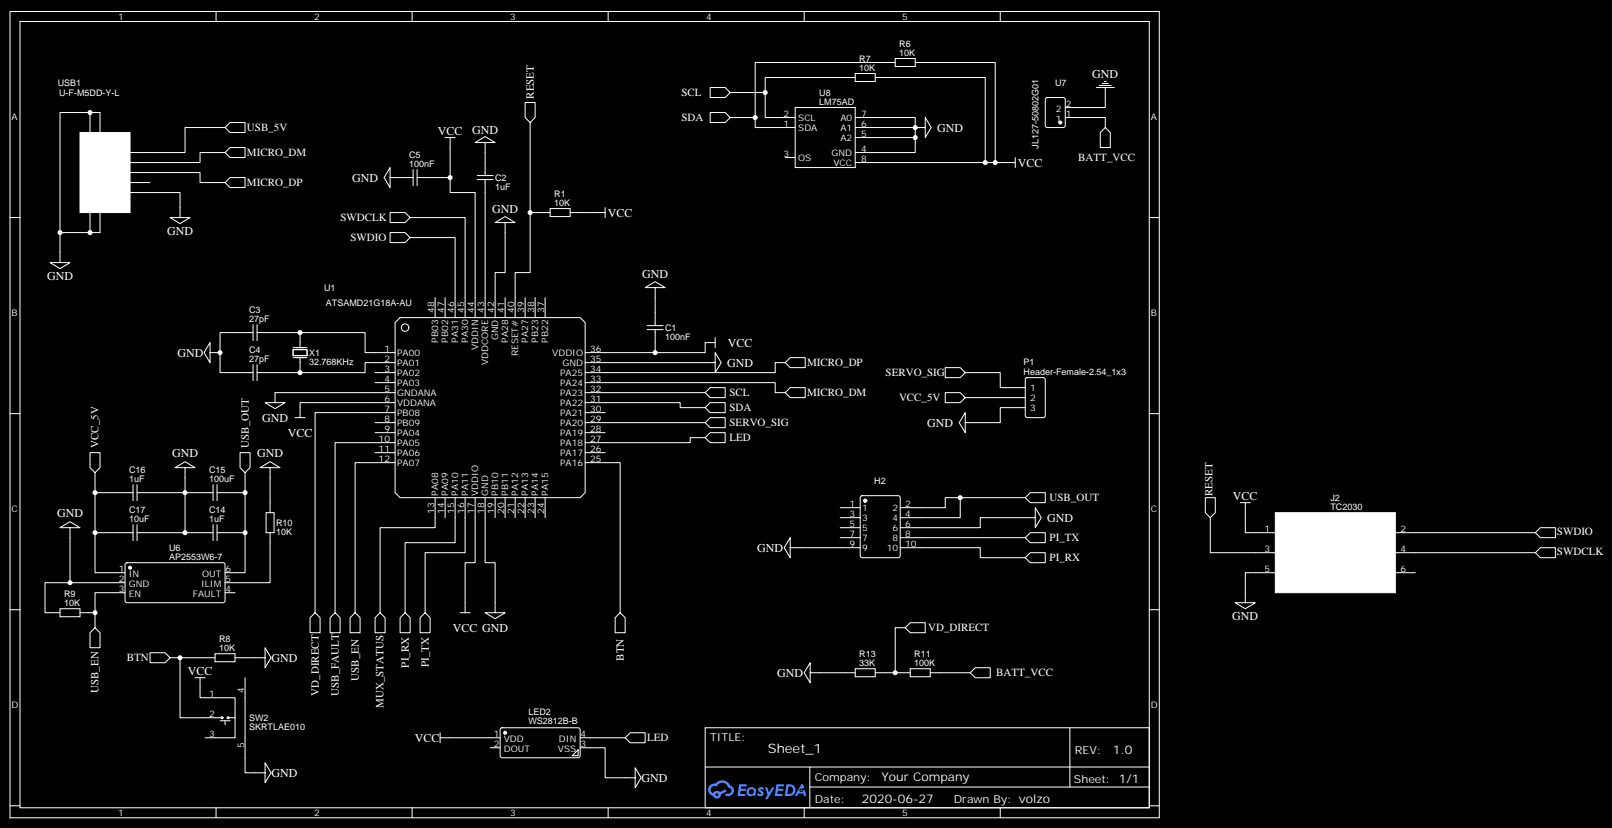
[picture p102: page 1]

PB22 37 PB23 38 PA27 39 RESET# 40 PA28 41 GND 42 VDDCORE 43 VDDIN 44 PA30 45 PA31 46 PB02 47 PB03 48

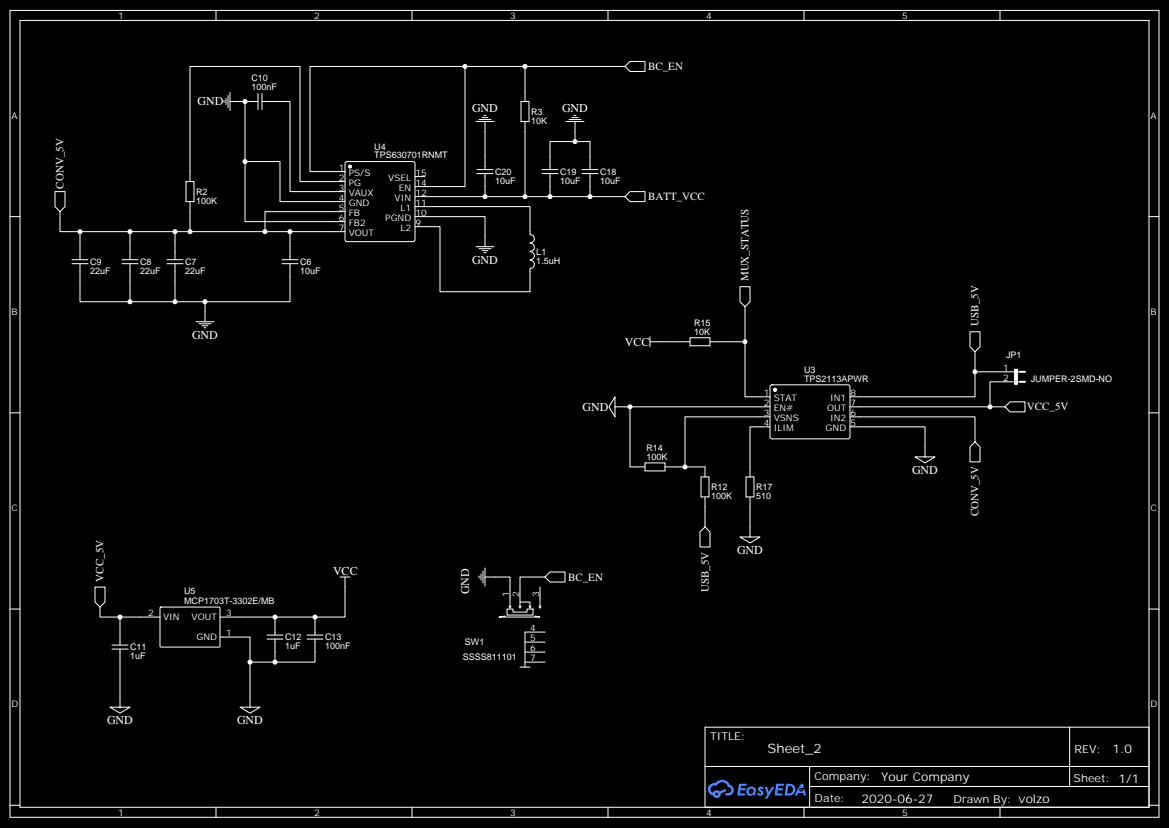
[picture p103: page 2]
