volzotan/CompressorCam/hardware/gerbers/CompressorCamRevH/Schematic_CompressorCamRevH.pdf

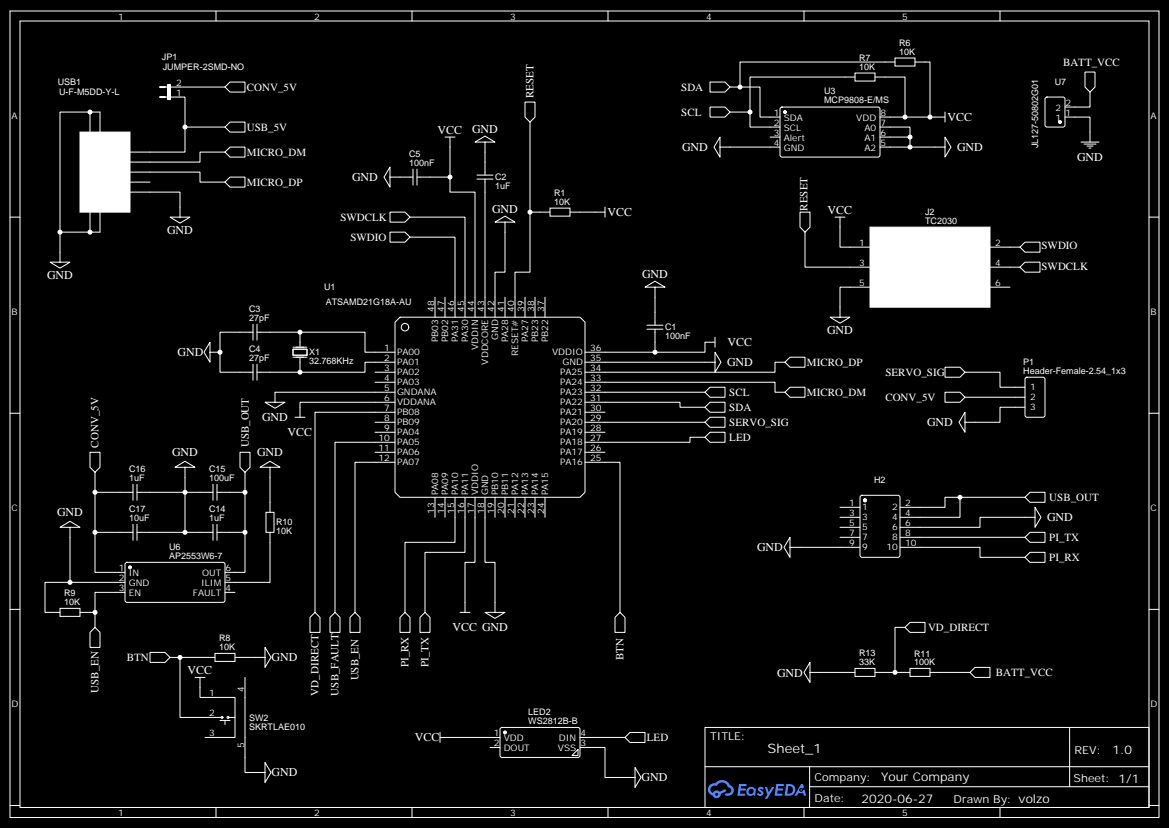
[picture p104: page 1]

PB22 37 PB23 38 PA27 39 RESET# 40 PA28 41 GND 42 VDDCORE 43 VDDIN 44 PA30 45 PA31 46 PB02 47 PB03 48

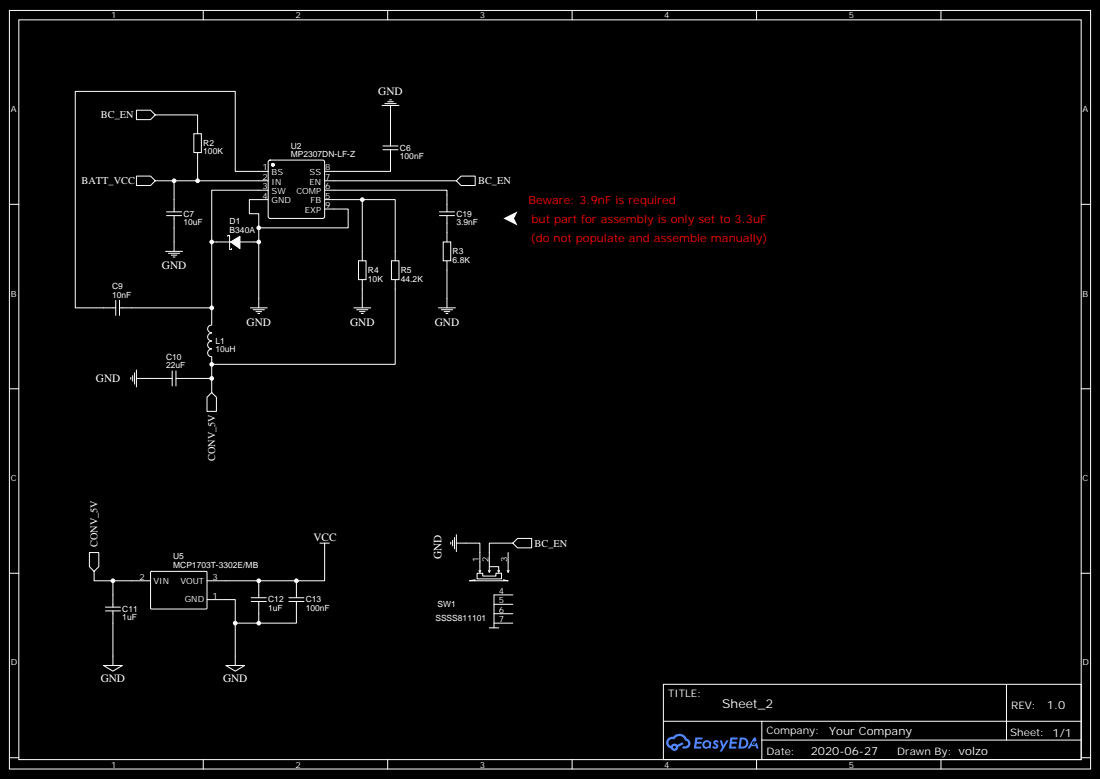
[picture p105: page 2]

Beware: 3.9nF is required
but part for assembly is only set to 3.3uF
(do not populate and assemble manually)
