volzotan/CompressorCam/(commit log)

2020-09-16 removed timebox I2C code
2020-09-16 switch from hostapd to wpa_supplicant only
2020-09-16 STLs added
    [LensHolderHQ_Bottom.stl, LensHolderHQ_Bottom_Cutout.stl, LensHolderHQ_HolderSimple.stl, LensHolderHQ_MountScrewSpacer.stl, LensHolderHQ_PogoHolder.stl, zerobox2S2P_4_Bottom.stl, zerobox2S2P_4_FilterHolder.stl, zerobox2S2P_4_Insert.stl]
2020-09-18 dnsmasq redirect compressor.camera
2020-09-19 bugfix/update buildroot UART wifi/bt module fix via device tree (do not update buildroot repo without updating the kernel info in your defconfig...)
2020-09-19 controller: handling of 2 and 3 cell lipo boards
2020-09-20 PCB files for RevH
    [BOM_CompressorCamRevH.csv, PickAndPlace_PCB.csv]
2020-09-20 renamed STLs and added STEPs
    [CCE_XL_Bottom.stl, CCE_XL_FilterHolder.stl, CCE_XL_Insert.stl, CCE_XL_Top.stl, DigitalSolargraphyCamera v28.step, zerobox2S2P_4_Insert.stl]
2020-09-24 docs: assembly instructions
2020-09-24 updated BOM
2020-09-24 BOM fix
2020-09-29 docs: assembly text updated
2020-10-02 minor updates for printed parts
    [CCE_XL_Insert.stl, LensHolderHQ_Bottom.stl, LensHolderHQ_Bottom_Cutout.stl, LensHolderHQ_PogoHolder.stl]
2020-10-06 hardware: missing schematic for revH
2020-10-10 controller: new temp sensor, battery detection levels changed, configuration values
2020-10-10 docs: assembly update
2020-10-11 docs: minor assembly updates
2020-10-14 docs: missing image for LED added
2020-10-14 hardware: revJ added
    [BOM_CompressorCamRevJ.csv, PickAndPlace_PCB.csv]
2020-10-16 controller: bugfix LED
2020-10-21 hardware: reduced bottom height by 2mm
    [CCE_XL_Bottom.stl]
2020-10-23 hardware: Insert changed to block light in white/gray enclosures ColdshoeAdapter added
    [CCE_XL_ColdshoeAdapter.stl, CCE_XL_Insert.stl]
2020-11-10 docs: LED image
2020-11-11 docs: button description updated
2020-11-11 docs: assembly guide update
2021-03-13 ccam: UART timeout (1s reduced to 0.2s)
2021-07-09 hardware: updated STLs
    [CCE_XL_Bottom.stl, CCE_XL_ColdshoeAdapter.stl, CCE_XL_FilterHolder.stl, CCE_XL_Insert.stl, CCE_XL_Top.stl, LensHolderHQ_HolderSimple.stl, LensHolderHQ_PogoHolder.stl]
2021-08-30 ccam: bugfixes (2nd exposure stalled on V1), warmup_wait time now a config value
2025-11-16 added missing STL/STEP files
    [BatteryWagoHolder1.stl, BatteryWagoHolder2.stl, CCE_M_MagnetHolder.stl, LensHolderHQ.f3d, LensHolderHQ.step, LensHolderHQ_BottomWago.stl, LensHolderHQ_HolderSimple.stl, LensHolderLQ.f3d]
